kuangmk11/shieldXL-euro/kicad/shieldXL-euro/shieldXL-euro-bom.csv

Refs | Qty | Value | Footprint | Manufacturer | MPN | DigiKey PN | DigiKey PN status | Notes
C1,C4,C8,C18,C47,C63 | 6 | 100n | C0603 | Samsung | CL10B104KB8NNNC | 1276-1000-1-ND | verified
C2,C5,C10,C12,C43 | 5 | 10u | C0805 | Samsung | CL21A106KAYNNNE | 1276-2891-1-ND | verified
C3,C35,C36,C38,C39,C41,C42,C44-C46,C88 | 11 | 10n | C0603 | Samsung | CL10B103KB8NNWC | 1276-1923-1-ND | verified
C9 | 1 | 47u | C1206 | Samsung | CL31A476MPHNNNE | 1276-3063-1-ND | pattern - confirm
C11,C13 | 2 | 220p COG | C0603 | Samsung | CL10C221JB8NNNC
C14,C16 | 2 | 3.3u | C0805 | Samsung | CL21A335KAQNNNE
C15,C17 | 2 | 2700p COG | C0603 | Murata | GRM1885C1H272JA01D
C101,C102,C121 | 3 | 10u 25V / 10u | C_0805_2012Metric | Samsung | CL21A106KAYNNNE | 1276-2891-1-ND | verified
C103,C104,C117-C120,C122 | 7 | 100n | C_0805_2012Metric | Samsung | CL21B104KBCNNNC | 1276-1003-1-ND | verified
C105-C108 | 4 | 100p | C_0805_2012Metric | Samsung | CL21C101JBANNNC | 1276-1014-1-ND | pattern - confirm
C113,C114-C116 | 4 | 47u / 47u 10V | C_1206_3216Metric | Samsung | CL31A476MPHNNNE | 1276-3063-1-ND | pattern - confirm
D1,D2 | 2 | RED 3mm | LED_3mm_PadsAC | Lite-On | LTL-4211N | 160-1956-ND | verified
D101,D102 | 2 | B5819W | D_SOD-123 | EVVO | B5819W | 5272-B5819WCT-ND | verified
D103 | 1 | SMBJ5.0CA | D_SMB | Littelfuse | SMBJ5.0CA | SMBJ5.0CALFCT-ND | verified
E1-E3 | 3 | ENC | PEC11RN | Bourns | PEC11R-4215F-N0024 | PEC11R-4215F-N0024-ND | verified
F101 | 1 | 3A hold | Fuse_1812_4532Metric | Littelfuse | 1812L300MR | F4162CT-ND | verified
J101 | 1 | Eurorack power | IDC-Header_2x05_P2.54mm_Vertical | Wurth | 61201021621 |  |  | boxed 2x5; any 2.54 mm shrouded header
J102,J103,J104,J105,J115,J116,J117,J118,J119,J120 | 10 | IN L / IN R / OUT L / OUT R / CORONE I/1 / CORONE I/2 / CORONE O/1 / CORONE O/2 / CORONE O/3 / CORONE O/4 | Jack_3.5mm_QingPu_WQP-PJ398SM_Vertical_CircularHoles | Thonk | Thonkiconn PJ398SM |  |  | not at Digi-Key: Thonk / Tayda
J106,J107 | 2 | MIDI IN / MIDI OUT | Jack_3.5mm_QingPu_WQP-PJ366ST_Vertical | Thonk | Thonkiconn PJ366ST (stereo) |  |  | not at Digi-Key: Thonk
J108 | 1 | DX07S024WJ1R350 | USB_C_Receptacle_JAE_DX07S024WJ1R350 | JAE | DX07S024WJ1R350 | 670-2949-1-ND | verified | backorder at Digi-Key when checked
J109,J110,J111 | 3 | USB 1 / USB 2 / USB 3 | USB_A_Molex_105057_Vertical | Molex | 1050570001 | WM8672-ND | verified
J112,J113 | 2 | Pi USB, inner stack / Pi USB, outer stack | IDC-Header_2x04_P2.54mm_Vertical | Wurth | 61200821621 |  |  | boxed 2x4, through hole - check the Wurth variant is THT
J121 | 1 | Corone | PinHeader_2x10_P2.54mm_Vertical | Sullins | PRPC010DAAN-RC
J122 | 1 | ii | PinHeader_1x03_P2.54mm_Vertical | Sullins | PRPC003SAAN-RC | S1011EC-03-ND | pattern - confirm
J123 | 1 | MIDI OUT A/B | PinHeader_2x03_P2.54mm_Vertical | Sullins | PRPC003DAAN-RC
L3 | 1 | FERRITE | L0805 | Murata | BLM21PG221SN1D | 490-1054-1-ND | verified
Q1 | 1 | ASFL1-12.288MHZ-LCS-T | ASF | Abracon | ASFL1-12.288MHZ-L-T | 535-10810-1-ND | verified | schematic value LCS-T; Digi-Key stocks the -L-T (same 12.288 MHz 3.3 V ASFL1)
R1-R4,R11,R13,R15,R26,R28,R29,R32,R34,R35,R38,R40,R41,R44-R49 | 22 | 10k | R0603 | Yageo | RC0603FR-0710KL | 311-10.0KHRCT-ND | pattern - confirm
R5,R19,R20 | 3 | 470Ω | R0603 | Yageo | RC0603FR-07470RL | 311-470HRCT-ND | pattern - confirm
R6,R16 | 2 | 220Ω | R0603 | Yageo | RC0603FR-07220RL | 311-220HRCT-ND | pattern - confirm
R7,R9 | 2 | 1.27k | R0603 | Yageo | RC0603FR-071K27L | 311-1.27KHRCT-ND | pattern - confirm
R8,R10 | 2 | 4.53k | R0603 | Yageo | RC0603FR-074K53L | 311-4.53KHRCT-ND | pattern - confirm
R12,R14 | 2 | 590 | R0603 | Yageo | RC0603FR-07590RL | 311-590HRCT-ND | pattern - confirm
R17 | 1 | 100Ω | R0603 | Yageo | RC0603FR-07100RL | 311-100HRCT-ND | pattern - confirm
R18 | 1 | 47Ω | R0603 | Yageo | RC0603FR-0747RL | 311-47.0HRCT-ND | pattern - confirm
R101,R103 | 2 | 69.8k | R_0805_2012Metric | Yageo | RC0805FR-0769K8L | 311-69.8KCRCT-ND | pattern - confirm
R102,R104 | 2 | 30.1k | R_0805_2012Metric | Yageo | RC0805FR-0730K1L | 311-30.1KCRCT-ND | pattern - confirm
R105,R108 | 2 | 10k | R_0805_2012Metric | Yageo | RC0805FR-0710KL | 311-10.0KCRCT-ND | pattern - confirm
R106,R109 | 2 | 16.2k | R_0805_2012Metric | Yageo | RC0805FR-0716K2L | 311-16.2KCRCT-ND | pattern - confirm
R107,R110 | 2 | 1k | R_0805_2012Metric | Yageo | RC0805FR-071KL | 311-1.00KCRCT-ND | pattern - confirm
R111,R112 | 2 | 5.1k | R_0805_2012Metric | Yageo | RC0805FR-075K1L | 311-5.10KCRCT-ND | pattern - confirm
SW1-SW3 | 3 | D6R00 F1 LFS | SW_CK_D6R | C&K | D6R00 F1 LFS | 108-D6R00F1LFS-ND | verified | white cap
U$1 | 1 | FPC1M20P-B310 | F-FPC1M20P-B310 | Ckmtw | F-FPC1M20P-B310 |  |  | not at Digi-Key: LCSC C132515
U1 | 1 | PCM3060PW | TSSOP-28_4.4x9.7mm_P0.65mm | TI | PCM3060PW | 296-21668-5-ND | verified | replaces the EOL CS4270; needs software/pcm3060-moirae
U2 | 1 | HCPL-0631-500E | SSOP-8_3.9x5.05mm_P1.27mm | Broadcom | HCPL-0631-500E | 516-1580-1-ND | verified
U11 | 1 | TPS793475DBVR | SSOP5 | TI | TPS793475DBVR | 296-TPS793475DBVRCT-ND | verified
U101 | 1 | TL074 | SOIC-14_3.9x8.7mm_P1.27mm | TI | TL074CDR | 296-1283-1-ND | verified
U102-U104 | 3 | USBLC6-2SC6 | SOT-23-6 | ST | USBLC6-2SC6 | 497-5235-1-ND | verified
U105 | 1 | 74LVC1G125 | SOT-23-5 | TI | SN74LVC1G125DBVR | 296-11603-1-ND | verified
X1 | 1 | RASPI_BOARD_B+#_E3 | RASPI_BOARD_B+_UPPER_HOLES | Raspberry Pi | Raspberry Pi 4 Model B |  |  | plus a 2x20 stacking header for the 20 mm stack
(J123) | 2 | shunt | - | Sullins | SPC02SYAN | S9001-ND | verified | MIDI out A/B: both on the top row = Type A
(X1) | 1 | 2x20 stacking header | - |  | 2x20 2.54 mm stacking header, long pins |  |  | Pi 20 mm behind the board on the 8.5 mm socket; not in the schematic
(COR1) | 2 | M3 standoff 11 mm F-F | - |  | M3 x 11 mm female-female standoff |  |  | Corone to main board, H1/H2; plus 4 M3 x 6 screws
(J112,J113) | 2 | 8-way ribbon, IDC both ends | - |  | 8-way 1.27 mm ribbon + 2x4 IDC sockets |  |  | to the two USB adapters; red stripe to pin 1 at both ends
