kuangmk11/shieldXL-euro/kicad/corone/corone-bom.csv

Refs | Qty | Value | Footprint | Manufacturer | MPN | DigiKey PN | DigiKey PN status | Notes
C1,C2,C4,C5,C7 | 5 | 10u 25V / 10u | C_0805_2012Metric | Samsung | CL21A106KAYNNNE | 1276-2891-1-ND | verified
C3,C6,C15,C30,C32-C35,C40 | 9 | 1u 25V / 1u | C_0603_1608Metric | Samsung | CL10A105KA8NNNC
C10-C13,C16,C20,C31,C36,C41,C42,C44,C60-C63,C80,C81 | 17 | 100n | C_0603_1608Metric | Samsung | CL10B104KB8NNNC | 1276-1000-1-ND | verified
C14 | 1 | 4u7 | C_0805_2012Metric | Samsung | CL21A475KAQNNNE
C17 | 1 | 2u2 | C_0603_1608Metric | Samsung | CL10A225KO8NNNC
C18,C19 | 2 | 12p | C_0603_1608Metric | Samsung | CL10C120JB8NNNC
C43 | 1 | 150n | C_0603_1608Metric | Samsung | CL10B154KA8NNNC
C50-C53 | 4 | 100p | C_0603_1608Metric | Samsung | CL10C101JB8NNNC
C70-C73 | 4 | 1n | C_0603_1608Metric | Samsung | CL10C102JB8NNNC
D1 | 1 | status | LED_0603_1608Metric | Lite-On | LTST-C191KRKT
D10,D11 | 2 | BAT54S | SOT-23 | Nexperia | BAT54S,215 | 1727-2904-1-ND | verified
FB1 | 1 | 600R@100MHz | L_0603_1608Metric | Murata | BLM18AG601SN1D | 490-1014-1-ND | verified
J1 | 1 | To main board | PinSocket_2x10_P2.54mm_Vertical | Samtec | SSW-110-01-T-D |  |  | 8.5 mm socket body (mates J121)
J2 | 1 | SWD | Tag-Connect_TC2030-IDC-NL_2x03_P1.27mm_Vertical | Tag-Connect | (pads only - TC2030-IDC-NL cable) |  |  | no part placed
J3 | 1 | Debug UART | PinHeader_1x03_P2.54mm_Vertical | Sullins | PRPC003SAAN-RC | S1011EC-03-ND | pattern - confirm
R10 | 1 | 10k | R_0603_1608Metric | Yageo | RC0603FR-0710KL | 311-10.0KHRCT-ND | pattern - confirm
R11,R52,R56,R60,R64,R72,R77 | 7 | 1k | R_0603_1608Metric | Yageo | RC0603FR-071KL | 311-1.00KHRCT-ND | pattern - confirm
R12,R13 | 2 | 2.2k | R_0603_1608Metric | Yageo | RC0603FR-072K2L | 311-2.20KHRCT-ND | pattern - confirm
R30,R70,R75 | 3 | 100k | R_0603_1608Metric | Yageo | RC0603FR-07100KL | 311-100KHRCT-ND | pattern - confirm
R40 | 1 | 30k | R_0603_1608Metric | Yageo | RC0603FR-0730KL | 311-30.0KHRCT-ND | pattern - confirm
R41 | 1 | 40k | R_0603_1608Metric | Yageo | RC0603FR-0740K2L | 311-40.2KHRCT-ND | pattern - confirm | 40k is not a 1% value: 40.2k used - confirm against crow
R50,R54,R58,R62 | 4 | 20k | R_0603_1608Metric | Yageo | RC0603FR-0720KL | 311-20.0KHRCT-ND | pattern - confirm
R51,R55,R59,R63 | 4 | 120k | R_0603_1608Metric | Yageo | RC0603FR-07120KL | 311-120KHRCT-ND | pattern - confirm
R71,R76 | 2 | 33.2k | R_0603_1608Metric | Yageo | RC0603FR-0733K2L | 311-33.2KHRCT-ND | pattern - confirm
SW1,SW2 | 2 | BOOT0 / RESET | SW_SPST_TL3342 | E-Switch | TL3342F160QG/TR | EG2531CT-ND | pattern - confirm
U1 | 1 | AMS1117-5.0 | SOT-223-3_TabPin2 | Diodes | AZ1117CH-5.0TRG1 | AZ1117CH-5.0TRG1DICT-ND | verified | AZ1117CH is the pin-compatible stocked equivalent
U2 | 1 | AP2112K-3.3 | SOT-23-5 | Diodes | AP2112K-3.3TRG1 | AP2112K-3.3TRG1DICT-ND | verified
U3 | 1 | ADS131A02IPBS | TQFP-32_7x7mm_P0.8mm | TI | ADS131A02IPBS | 296-44812-ND | verified
U4 | 1 | DAC8565IAPW | TSSOP-16_4.4x5mm_P0.65mm | TI | DAC8565IAPW | 296-22924-5-ND | verified
U5,U6 | 2 | OPA4197 | TSSOP-14_4.4x5mm_P0.65mm | TI | OPA4197IPWR | 296-45060-1-ND | verified
U7 | 1 | ADG1408YRUZ | TSSOP-16_4.4x5mm_P0.65mm | Analog Devices | ADG1408YRUZ | 505-ADG1408YRUZ-ND | verified
U8 | 1 | STM32F722RET6 | LQFP-64_10x10mm_P0.5mm | ST | STM32F722RET6 | 497-17184-ND | verified
U9 | 1 | USBLC6-2SC6 | SOT-23-6 | ST | USBLC6-2SC6 | 497-5235-1-ND | verified
Y1 | 1 | 8MHz | Crystal_SMD_3225-4Pin_3.2x2.5mm |  | 8 MHz 3225 crystal, ~10 pF load (12 pF caps)
