kuangmk11/shieldXL-euro/kicad/shieldXL-euro/3d/USB_adapter.step

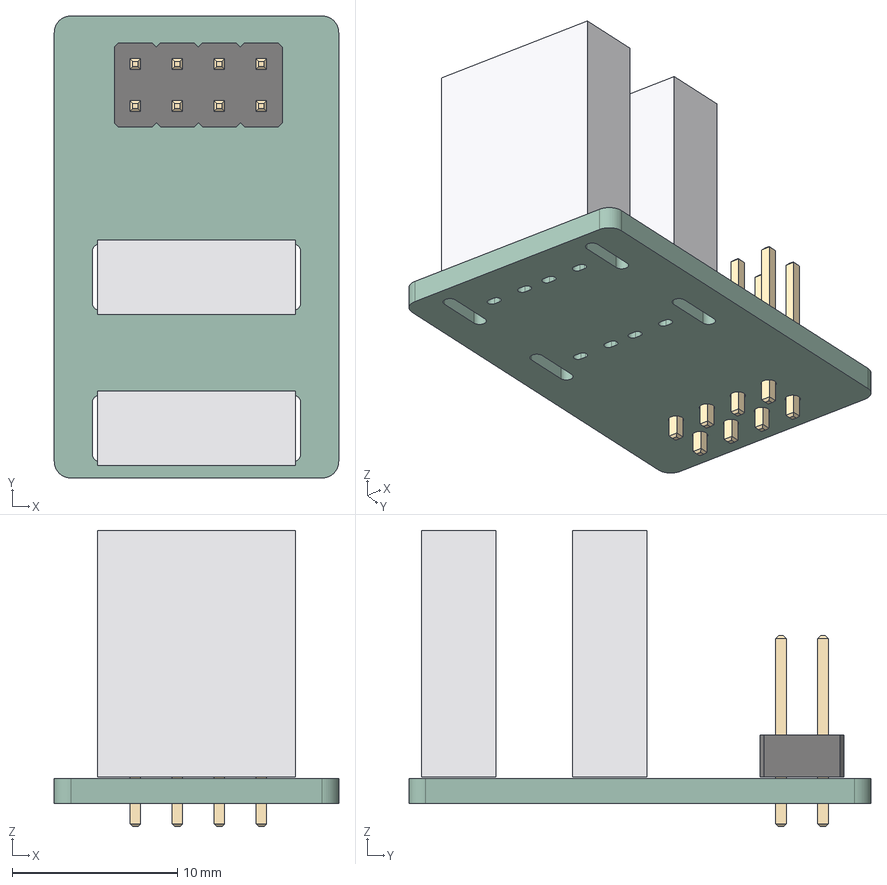
[picture p1: CAD file, 2026-10-17]
kicad/shieldXL-euro/3d/USB_adapter.step
17.2 x 27.9 x 17.9 mm
plug_PCB x 2
PinHeader_2x04_P2.54mm_Vertical
usb-adapter_PCB
