kuangmk11/shieldXL-euro/kicad/usb-adapter/3d/USB_A_plug_placeholder.step

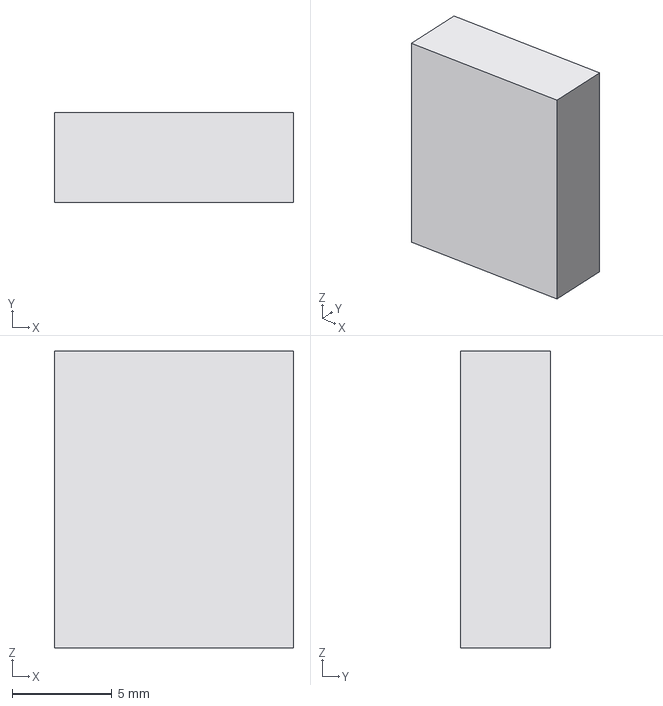
[picture p2: CAD file, 2026-10-17]
kicad/usb-adapter/3d/USB_A_plug_placeholder.step
12.0 x 4.50 x 14.9 mm
