kuangmk11/shieldXL-euro/kicad/shieldXL-euro/3d/Corone.step

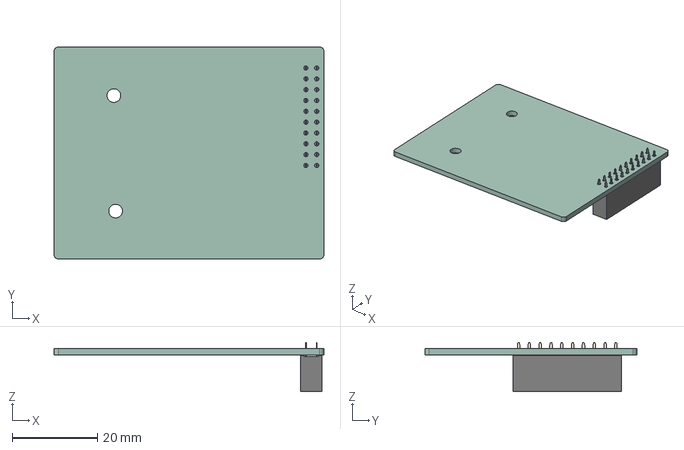
[picture p3: CAD file, 2026-10-17]
kicad/shieldXL-euro/3d/Corone.step
63.4 x 49.8 x 11.6 mm
PinSocket_2x10_P2.54mm_Vertical
corone_PCB
