kuangmk11/shieldXL-euro/kicad/shieldXL-euro/3d/Moirae_panel.step

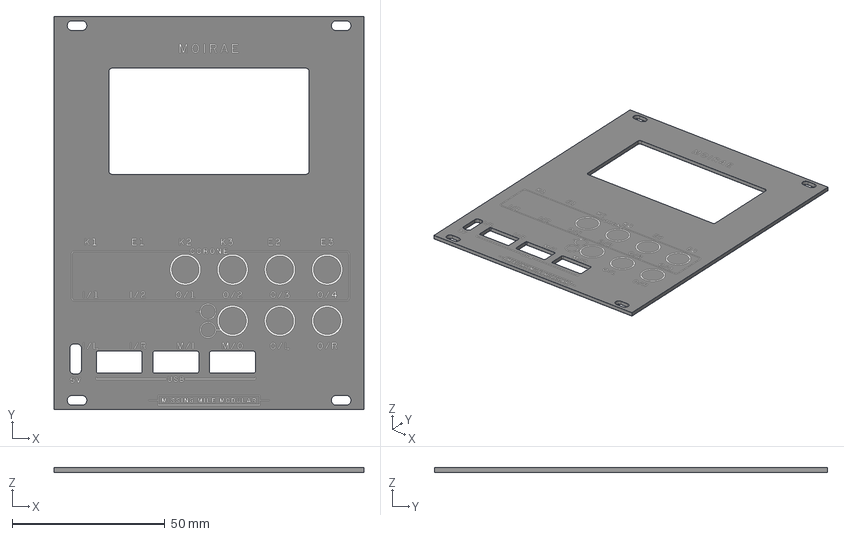
[picture p4: CAD file, 2026-10-17]
kicad/shieldXL-euro/3d/Moirae_panel.step
101.3 x 128.5 x 1.66 mm
panel_silkscreen x 2
panel_soldermask x 2
panel_PCB
