kuangmk11/shieldXL-euro/kicad/shieldXL-euro/3d/DX07S024WJ1R350.stp

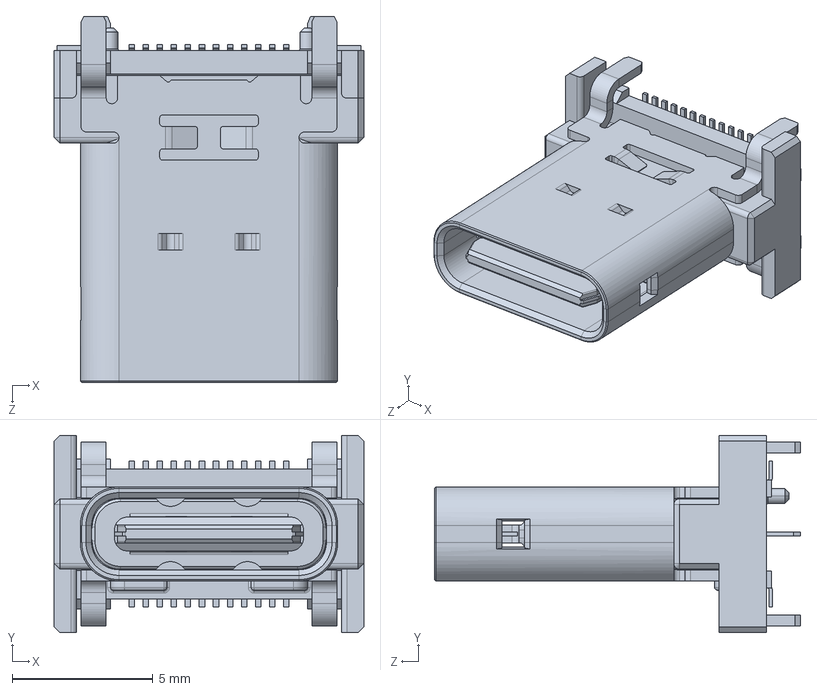
[picture p5: CAD file, 2026-10-16]
kicad/shieldXL-euro/3d/DX07S024WJ1R350.stp
11.0 x 7.00 x 13.0 mm
