kuangmk11/shieldXL-euro/kicad/shieldXL-euro/3d/NHD-2.7-12864WDx3-CTP.step

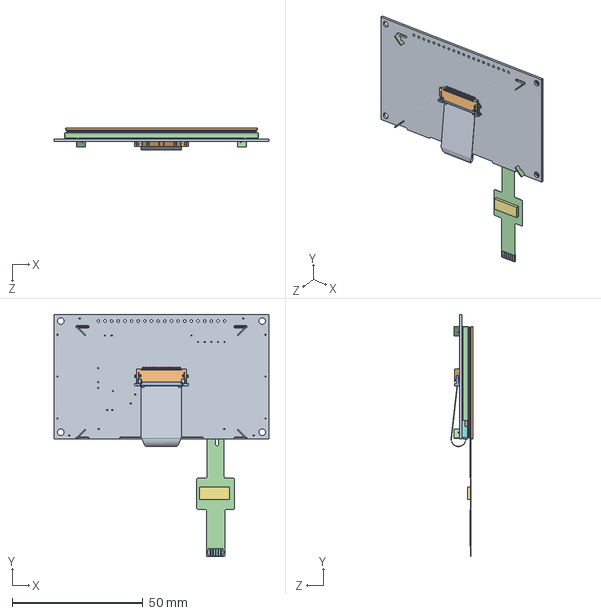
[picture p6: CAD file, 2026-10-16]
kicad/shieldXL-euro/3d/NHD-2.7-12864WDx3-CTP.step
82.0 x 92.5 x 8.34 mm
