kuangmk11/shieldXL-euro/kicad/shieldXL-euro/3d/SW-D6R00-F2-LFS.stp

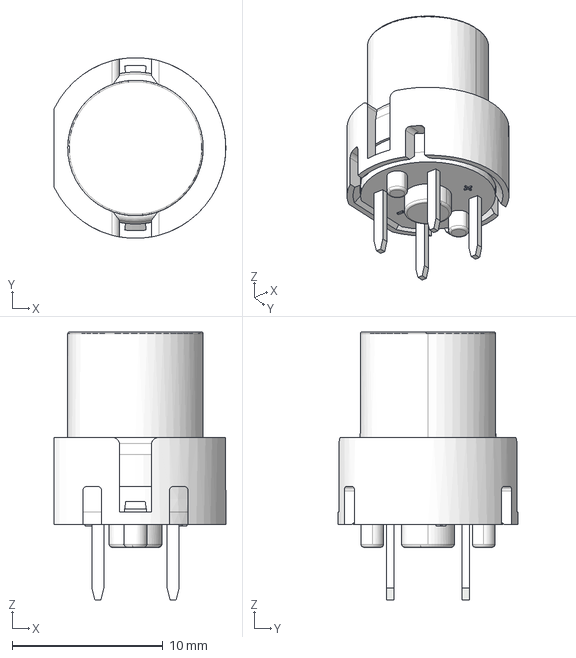
[picture p7: CAD file, 2026-10-16]
kicad/shieldXL-euro/3d/SW-D6R00-F2-LFS.stp
11.4 x 12.0 x 17.8 mm
