kuangmk11/shieldXL-euro/kicad/shieldXL-euro/3d/200MSPxT2B1M2xE.stp

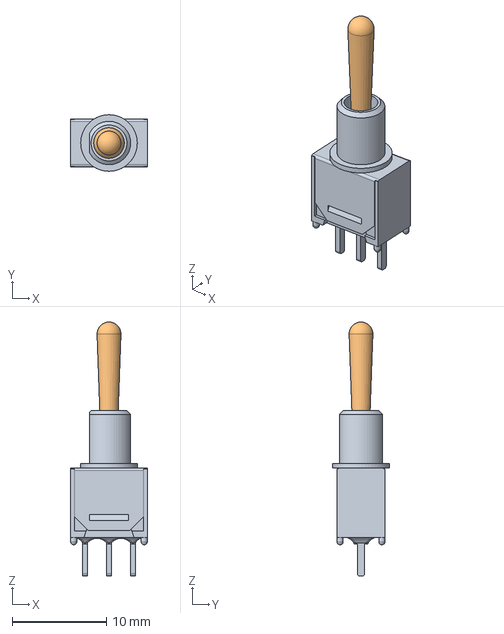
[picture p8: CAD file, 2026-10-15]
kicad/shieldXL-euro/3d/200MSPxT2B1M2xE.stp
8.13 x 6.00 x 26.9 mm
