kuangmk11/shieldXL-euro/kicad/shieldXL-euro/3d/200MDPxT2B1M2xE.stp

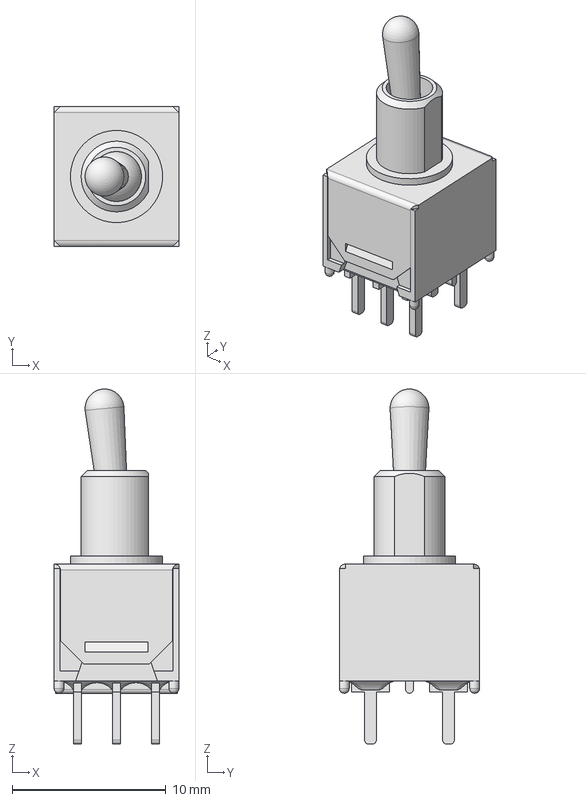
[picture p9: CAD file, 2026-10-15]
kicad/shieldXL-euro/3d/200MDPxT2B1M2xE.stp
8.13 x 9.14 x 23.1 mm
