kuangmk11/shieldXL-euro/kicad/shieldXL-euro/3d/2047110001.stp

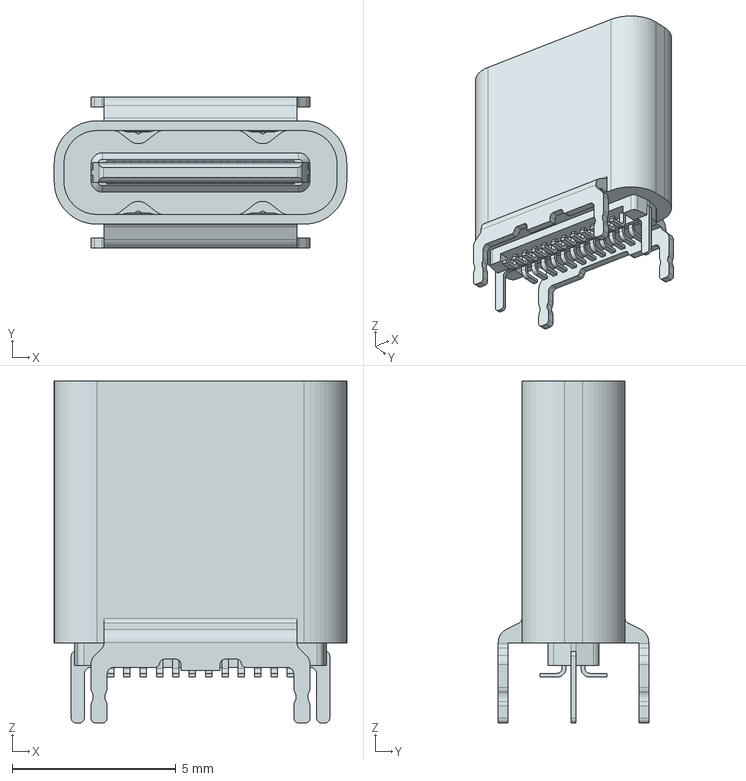
[picture p10: CAD file, 2026-10-16]
kicad/shieldXL-euro/3d/2047110001.stp
8.94 x 4.60 x 10.4 mm
