kuangmk11/shieldXL-euro/kicad/shieldXL-euro/shieldXL-euro.kicad_pcb

## KiCad design kicad/shieldXL-euro/shieldXL-euro.kicad_pcb (2026-10-17)

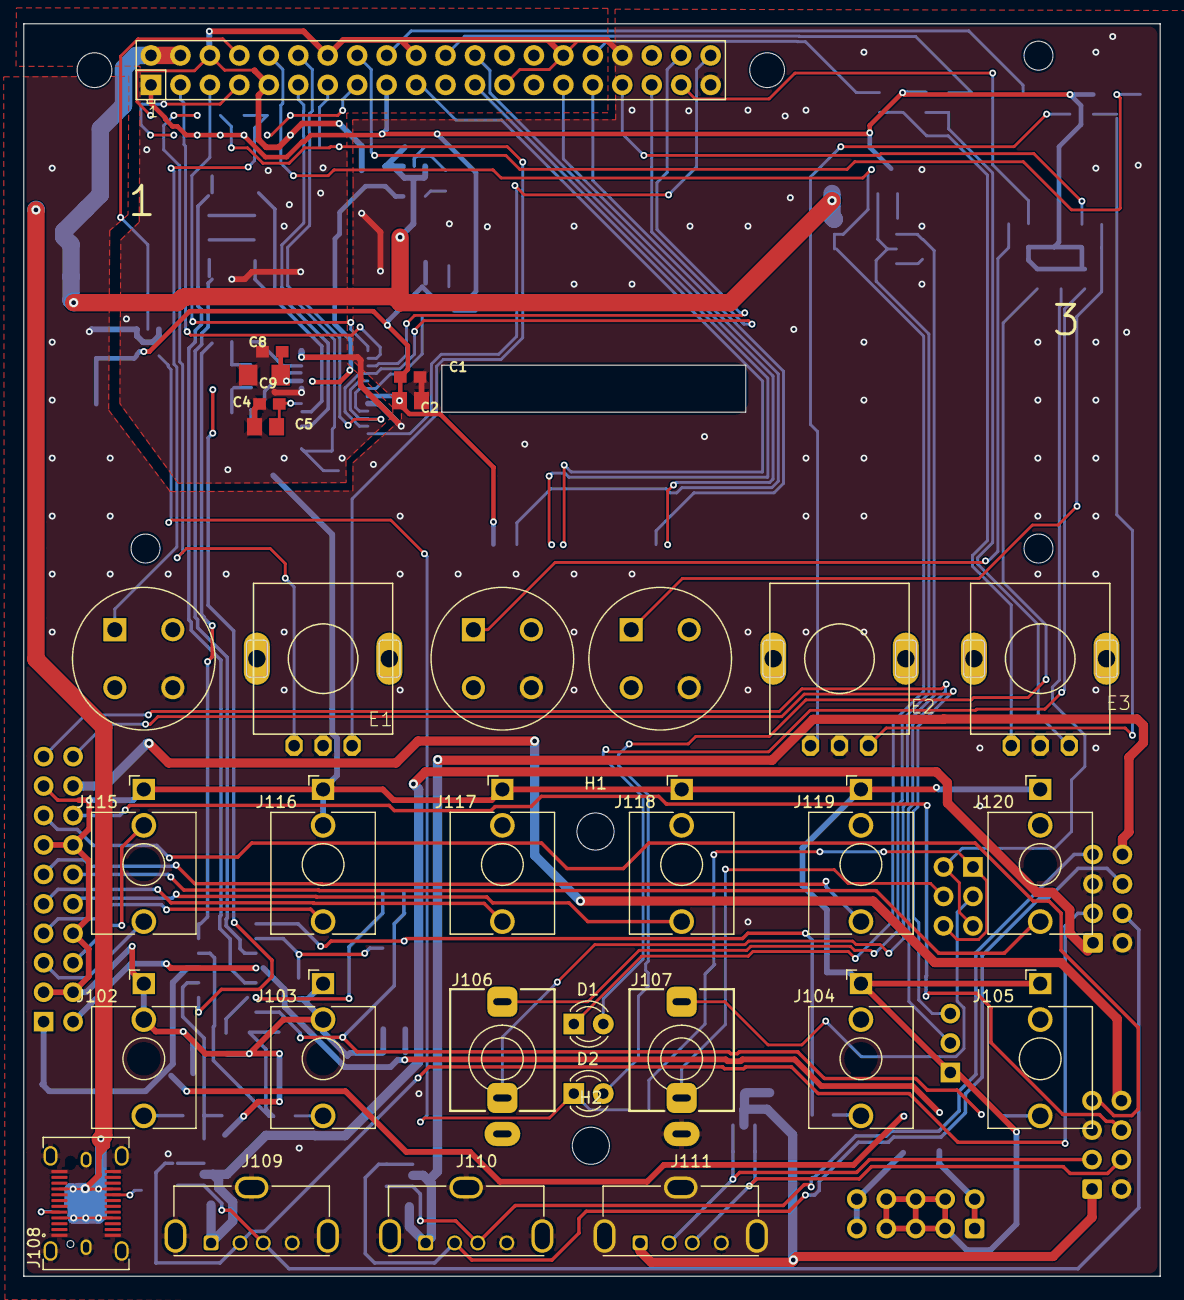
[picture p11: board shieldXL-euro.kicad_pcb from above]

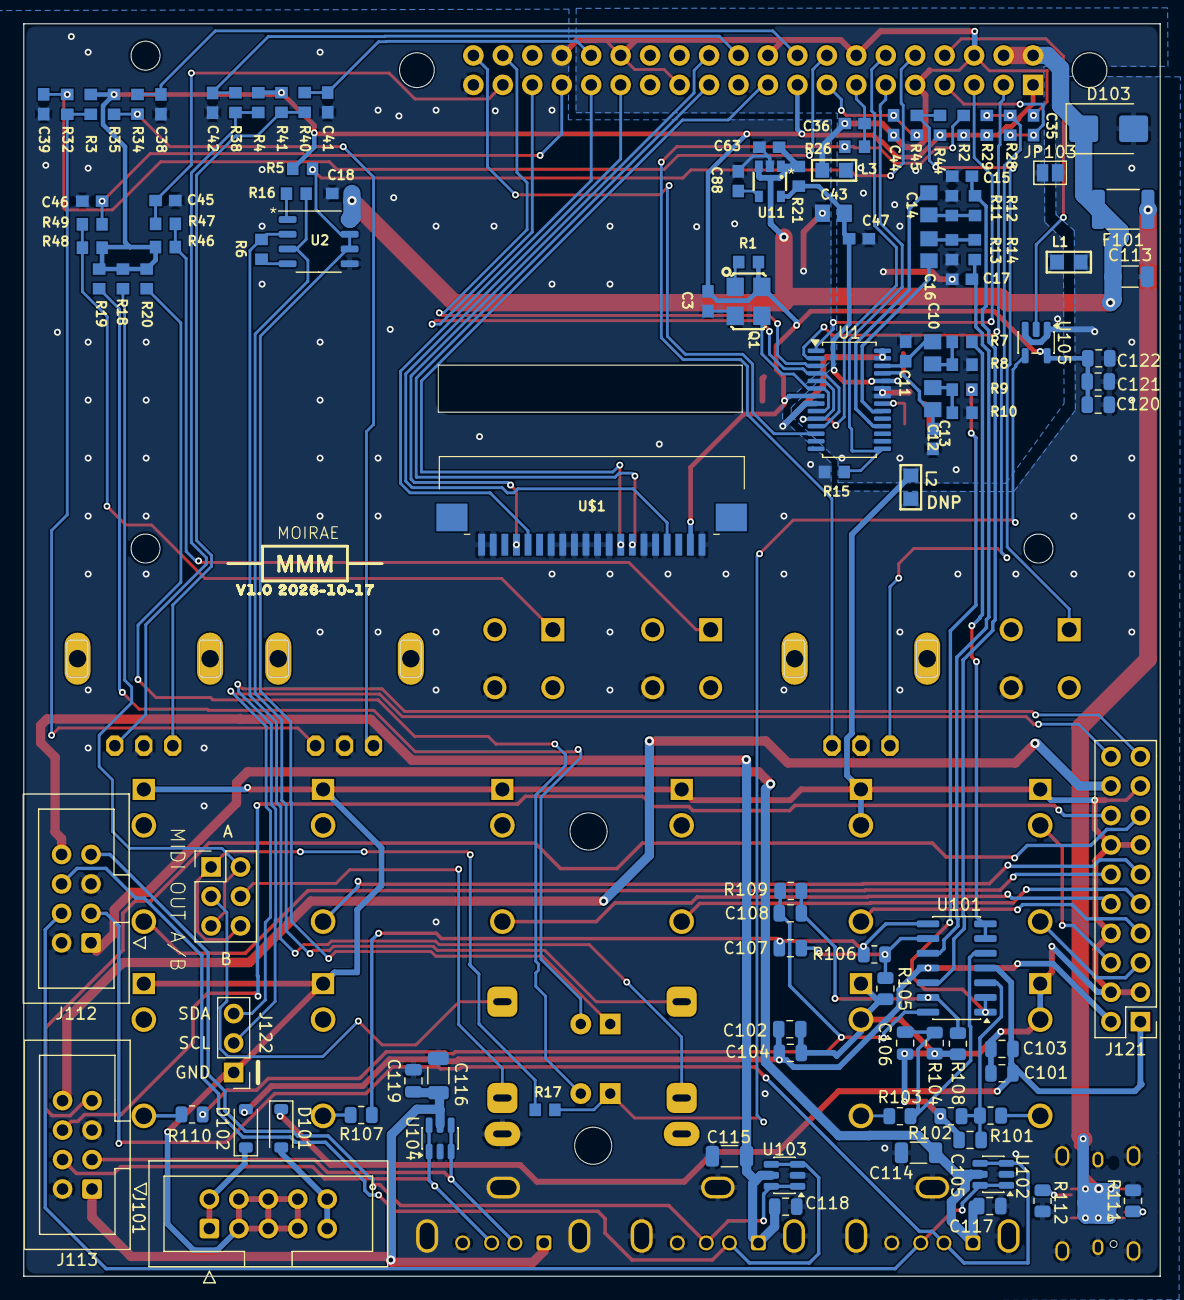
[picture p12: board shieldXL-euro.kicad_pcb from below]

Board: 2 copper layers, 98.0 x 108.0 mm, 151 parts (113 on the bottom side), 102 nets.

Parts:
C1, C4, C8, C18, C47, C63: 100n; C0603
C2, C5, C10, C12, C43: 10u; C0805
C3, C35, C36, C38, C39, C41, C42, C44, C45, C46, C88: 10n; C0603
C9: 47u; C1206
C11, C13: 220p COG; C0603
C14, C16: 3.3u; C0805
C15, C17: 2700p COG; C0603
C101, C102: 10u 25V; C_0805_2012Metric
C103, C104, C117, C118, C119, C120, C122: 100n; C_0805_2012Metric
C105, C106, C107, C108: 100p; C_0805_2012Metric
C113: 47u; C_1206_3216Metric
C114, C115, C116: 47u 10V; C_1206_3216Metric
C121: 10u; C_0805_2012Metric
COR1: Corone; Corone_Daughterboard
D1, D2: RED 3mm; LED_3mm_PadsAC
D101, D102: B5819W; D_SOD-123
D103: SMBJ5.0CA; D_SMB
DS1: NHD-2.7-12864WDW3-M; Display_NHD-2.7-12864WDW3
E1, E2, E3: ENC; PEC11RN
F101: 3A hold; Fuse_1812_4532Metric
H1, H2: M3; MountingHole_3.2mm_M3
J101: Eurorack power; IDC-Header_2x05_P2.54mm_Vertical
J102: IN L; Jack_3.5mm_QingPu_WQP-PJ398SM_Vertical_CircularHoles
J103: IN R; Jack_3.5mm_QingPu_WQP-PJ398SM_Vertical_CircularHoles
J104: OUT L; Jack_3.5mm_QingPu_WQP-PJ398SM_Vertical_CircularHoles
J105: OUT R; Jack_3.5mm_QingPu_WQP-PJ398SM_Vertical_CircularHoles
J106: MIDI IN; Jack_3.5mm_QingPu_WQP-PJ366ST_Vertical
J107: MIDI OUT; Jack_3.5mm_QingPu_WQP-PJ366ST_Vertical
J108: DX07S024WJ1R350; USB_C_Receptacle_JAE_DX07S024WJ1R350
J109: USB 1; USB_A_Molex_105057_Vertical
J110: USB 2; USB_A_Molex_105057_Vertical
J111: USB 3; USB_A_Molex_105057_Vertical
J112: Pi USB, inner stack; IDC-Header_2x04_P2.54mm_Vertical
J113: Pi USB, outer stack; IDC-Header_2x04_P2.54mm_Vertical
J115: CORONE I/1; Jack_3.5mm_QingPu_WQP-PJ398SM_Vertical_CircularHoles
J116: CORONE I/2; Jack_3.5mm_QingPu_WQP-PJ398SM_Vertical_CircularHoles
J117: CORONE O/1; Jack_3.5mm_QingPu_WQP-PJ398SM_Vertical_CircularHoles
J118: CORONE O/2; Jack_3.5mm_QingPu_WQP-PJ398SM_Vertical_CircularHoles
J119: CORONE O/3; Jack_3.5mm_QingPu_WQP-PJ398SM_Vertical_CircularHoles
J120: CORONE O/4; Jack_3.5mm_QingPu_WQP-PJ398SM_Vertical_CircularHoles
J121: Corone; PinHeader_2x10_P2.54mm_Vertical
J122: ii; PinHeader_1x03_P2.54mm_Vertical
J123: MIDI OUT A/B; PinHeader_2x03_P2.54mm_Vertical
JP103: AGND-GND; SolderJumper-2_P1.3mm_Open_Pad1.0x1.5mm
L1, L2: DNP; L0805
L3: FERRITE; L0805
PNL1: Moirae panel; Panel_Moirae
Q1: ASFL1-12.288MHZ-LCS-T; ASF
R1, R2, R3, R4, R11, R13, R15, R26, R28, R29, R32, R34, R35, R38, R40, R41, R44, R45, R46, R47, R48, R49: 10k; R0603
R5, R19, R20: 470Ω; R0603
R6, R16: 220Ω; R0603
R7, R9: 1.27k; R0603
R8, R10: 4.53k; R0603
R12, R14: 590; R0603
R17: 100Ω; R0603
R18: 47Ω; R0603
R21: DNP; R0603
R101, R103: 69.8k; R_0805_2012Metric
R102, R104: 30.1k; R_0805_2012Metric
R105, R108: 10k; R_0805_2012Metric
R106, R109: 16.2k; R_0805_2012Metric
R107, R110: 1k; R_0805_2012Metric
R111, R112: 5.1k; R_0805_2012Metric
SW1, SW2, SW3: D6R00 F1 LFS; SW_CK_D6R
U1: PCM3060PW; TSSOP-28_4.4x9.7mm_P0.65mm
U2: HCPL-0631-500E; SSOP-8_3.9x5.05mm_P1.27mm
U11: TPS793475DBVR; SSOP5
U101: TL074; SOIC-14_3.9x8.7mm_P1.27mm
U102, U103, U104: USBLC6-2SC6; SOT-23-6
U105: 74LVC1G125; SOT-23-5
U$1: FPC1M20P-B310; F-FPC1M20P-B310
USBA1, USBA2: USB adapter; USB_Adapter_Pi
X1: RASPI_BOARD_B+#_E3; RASPI_BOARD_B+_UPPER_HOLES

Connections:
+3V3: C1.1, C2.1, C3.1, C120.1, C121.1, C122.1, Q1.4 (VCC), R1.1, R2.2, R3.2, R4.2, R5.2, R18.2, R19.2, R20.2, R29.2, R35.2, R41.2, R44.1, R46.1, R48.1, U1.7 (VDD), U105.5 (VCC), U$1.2 (VDD), X1.1 (3V3A), X1.17 (3V3B)
+5V: C18.2, C63.1, C113.1, D103.1 (A1), F101.2, R21.1, U2.8 (VCC), U11.1 (IN), U11.3 (EN), X1.2 (5V0A), X1.4 (5V0B)
+12V: C101.1, C103.1, D101.1 (K), J121.1, U101.4 (V+)
-12V: C102.2, C104.2, D102.2 (A), J121.2, U101.11 (V-)
/eurorack/+12V_IN: D101.2 (A), J101.9, J101.10
/eurorack/-12V_IN: D102.1 (K), J101.1, J101.2
/eurorack/CC1: J108.A5 (CC1), R111.1
/eurorack/CC2: J108.B5 (CC2), R112.1
/eurorack/CRW_IN1: J115.T, J121.5
/eurorack/CRW_IN1_NORM: J115.TN, J121.6
/eurorack/CRW_IN2: J116.T, J121.7
/eurorack/CRW_OUT1: J117.T, J121.9
/eurorack/CRW_OUT2: J118.T, J121.10
/eurorack/CRW_OUT3: J119.T, J121.11
/eurorack/CRW_OUT4: J120.T, J121.12
/eurorack/CRW_USB_DM: J113.6, J121.16
/eurorack/CRW_USB_DP: J113.7, J121.15
/eurorack/CRW_USB_VBUS: J113.8, J121.18
/eurorack/II_SCL: J121.19, J122.2
/eurorack/II_SDA: J121.20, J122.3
/eurorack/INL_DIV: C105.1, R101.2, R102.1, U101.3 (+)
/eurorack/INR_DIV: C106.1, R103.2, R104.1, U101.5 (+)
/eurorack/IN_L_JACK: J102.T, R101.1
/eurorack/IN_R_JACK: J103.T, R103.1
/eurorack/MIDI_OUT_R: J107.R, J123.4
/eurorack/MIDI_OUT_T: J107.T, J123.3
/eurorack/OUTL_AMP: C107.2, R106.2, R107.1, U101.8
/eurorack/OUTL_FB: C107.1, R105.1, R106.1, U101.9 (-)
/eurorack/OUTR_AMP: C108.2, R109.2, R110.1, U101.14
/eurorack/OUTR_FB: C108.1, R108.1, R109.1, U101.13 (-)
/eurorack/OUT_L_JACK: J104.T, R107.2
/eurorack/OUT_R_JACK: J105.T, R110.2
/eurorack/USB1_DM: J109.2 (D-), J112.3, U102.3 (I/O2), U102.4 (I/O2)
/eurorack/USB1_DP: J109.3 (D+), J112.4, U102.1 (I/O1), U102.6 (I/O1)
/eurorack/USB1_VBUS: C114.1, C117.1, J109.1 (VBUS), J112.1, U102.5 (VBUS)
/eurorack/USB2_DM: J110.2 (D-), J112.6, U103.3 (I/O2), U103.4 (I/O2)
/eurorack/USB2_DP: J110.3 (D+), J112.7, U103.1 (I/O1), U103.6 (I/O1)
/eurorack/USB2_VBUS: C115.1, C118.1, J110.1 (VBUS), J112.8, U103.5 (VBUS)
/eurorack/USB3_DM: J111.2 (D-), J113.3, U104.3 (I/O2), U104.4 (I/O2)
/eurorack/USB3_DP: J111.3 (D+), J113.4, U104.1 (I/O1), U104.6 (I/O1)
/eurorack/USB3_VBUS: C116.1, C119.1, J111.1 (VBUS), J113.1, U104.5 (VBUS)
/eurorack/VBUS_C: F101.1, J108.A4 (VBUS), J108.A9 (VBUS), J108.B4 (VBUS), J108.B9 (VBUS)
/norns-shield-210330_1/A5V: C8.1, C9.1, C43.1, C47.1, R21.2, U1.24 (VCC), U11.6 (OUT)
/norns-shield-210330_1/INA: C10.1, C11.1, U1.26 (VINR)
/norns-shield-210330_1/INB: C12.1, C13.1, U1.25 (VINL)
/norns-shield-210330_1/LRCK: U1.4 (LRCK1), U1.11 (LRCK2), X1.35 (GPIO19)
/norns-shield-210330_1/MCLK: Q1.3 (FO), U1.6 (SCKI1), U1.9 (SCKI2)
/norns-shield-210330_1/OUTA: C14.1, U1.18 (VOUTR+)
/norns-shield-210330_1/OUTB: C16.1, U1.20 (VOUTL+)
/norns-shield-210330_1/R-CODEC: R15.1, U1.15 (~RST), X1.11 (GPIO17)
/norns-shield-210330_1/SCL: U1.1 (MC/SCL), X1.5 (SCL)
/norns-shield-210330_1/SCLK: U1.5 (BCK1), U1.10 (BCK2), X1.12 (GPIO18)
/norns-shield-210330_1/SDA: U1.2 (MD/SDA), X1.3 (SDA)
/norns-shield-210330_1/SDIN: U1.12 (DIN), X1.40 (GPIO21)
/norns-shield-210330_1/SDOUT: U1.3 (DOUT), X1.38 (GPIO20)
A1: C35.1, R28.2, X1.7 (GPIO04)
A2: C38.1, R34.2, X1.18 (GPIO24)
A3: C41.1, R40.2, X1.32 (GPIO12)
AGND: C4.2, C5.2, C8.2, C9.2, C11.2, C13.2, C15.2, C17.2, C47.2, C101.2, C102.1, C103.2, C104.1, C105.2, C106.2, J101.3, J101.4, J101.5, J101.6, J101.7, J101.8, J102.S, J102.TN, J103.S, J103.TN, J104.S, J105.S, J115.S, J116.S, J116.TN, J117.S, J118.S, J119.S, J120.S, J121.3, J121.4, J121.8, J121.13, J121.14, J121.17, J122.1, JP103.1 (A), L1.1, L2.1, L3.1, R8.2, R10.2, R11.2, R13.2, R102.2, R104.2, R105.2, R108.2, U1.16 (SGND), U1.22 (AGND2), U1.23 (AGND1)
B1: C36.1, R26.2, X1.13 (GPIO27)
B2: C39.1, R32.2, X1.16 (GPIO23)
B3: C42.1, R38.2, X1.22 (GPIO25)
CE0: U$1.17 (/CS), X1.24 (SPI_CE0)
GND: C1.2, C2.2, C3.2, C18.1, C35.2, C36.2, C38.2, C39.2, C41.2, C42.2, C43.2, C44.2, C45.2, C46.2, C63.2, C88.2, C113.2, C114.2, C115.2, C116.2, C117.2, C118.2, C119.2, C120.2, C121.2, C122.2, D103.2 (A2), E1.GND, E2.GND, E3.GND, J107.S, J108.A1 (GND), J108.A12 (GND), J108.B1 (GND), J108.B12 (GND), J108.SH (SHIELD), J109.4 (GND), J109.SH (Shield), J110.4 (GND), J110.SH (Shield), J111.4 (GND), J111.SH (Shield), J112.2, J112.5, J113.2, J113.5, JP103.2 (B), L1.2, L2.2, L3.2, Q1.2 (GND), R15.2, R111.2, R112.2, SW1.SW2 (PIN-2), SW2.SW2 (PIN-2), SW3.SW2 (PIN-2), U1.8 (DGND), U1.27 (MS/ADR), U1.28 (MODE), U2.5 (GND), U11.2 (GND), U102.2 (GND), U103.2 (GND), U104.2 (GND), U105.1, U105.3 (GND), U$1.1 (VSS), U$1.5 (R/W), U$1.6 (E), U$1.9 (DB2), U$1.10 (DB3), U$1.11 (DB4), U$1.12 (DB5), U$1.13 (DB6), U$1.14 (DB7), U$1.19 (BS1), U$1.20 (BS0), X1.6 (GND_A), X1.9 (GND_B), X1.14 (GND_C), X1.20 (GND_D), X1.25 (GND_E), X1.30 (GND_F), X1.34 (GND_G), X1.39 (GND_H)
IN_L_LINE: R9.2, U101.1, U101.2 (-)
IN_R_LINE: R7.2, U101.6 (-), U101.7
K1: C44.1, R45.2, X1.15 (GPIO22)
K2: C45.1, R47.2, X1.37 (GPIO26)
K3: C46.1, R49.2, X1.33 (GPIO13)
MIDI_IN_RING: J106.R, R6.1, U2.2 (CATHODE_1)
MIDI_IN_TIP: J106.T, R16.1, U2.3 (CATHODE_2)
MIDI_OUT_SNK: J123.1, J123.6, R17.1
MIDI_OUT_SRC: J123.2, J123.5, R18.1
MIDI_RX: D1.C, R5.1, U2.6 (VO2), U2.7 (VO1), X1.10 (RXD)
MIDI_TX: U105.2, X1.8 (TXD)
MIDI_TX_BUF: D2.C, R17.2, U105.4
MOSI: U$1.8 (SDIN), X1.19 (SPI_MOSI)
unnamed: C10.2, R7.1, R8.1
unnamed: C12.2, R9.1, R10.1
unnamed: C14.2, R11.1, R12.1
unnamed: C16.2, R13.1, R14.1
unnamed: D1.A, R19.1
unnamed: D2.A, R20.1
unnamed: E1.A, R28.1, R29.1
unnamed: E1.B, R2.1, R26.1
unnamed: E2.A, R34.1, R35.1
unnamed: E2.B, R3.1, R32.1
unnamed: E3.A, R40.1, R41.1
unnamed: E3.B, R4.1, R38.1
unnamed: Q1.1 (OE), R1.2
unnamed: R44.2, R45.1, SW1.SW1 (PIN-1)
unnamed: R46.2, R47.1, SW2.SW1 (PIN-1)
unnamed: R48.2, R49.1, SW3.SW1 (PIN-1)
unnamed: C4.1, C5.1, U1.21 (VCOM)
unnamed: R16.2, U2.1 (ANODE_1)
unnamed: R6.2, U2.4 (ANODE_2)
unnamed: C88.1, U11.4 (NR)
OUT_L_LINE: C17.1, R14.2, U101.10 (+)
OUT_R_LINE: C15.1, R12.2, U101.12 (+)
O_DC: U$1.4 (D/C), X1.29 (GPIO05)
O_RESET: U$1.16 (/RES), X1.31 (GPIO06)
SCK: U$1.7 (SCLK), X1.23 (SPI_SCLK)
