kuangmk11/shieldXL-euro/kicad/corone/corone.kicad_pcb

## KiCad design kicad/corone/corone.kicad_pcb (2026-10-17)

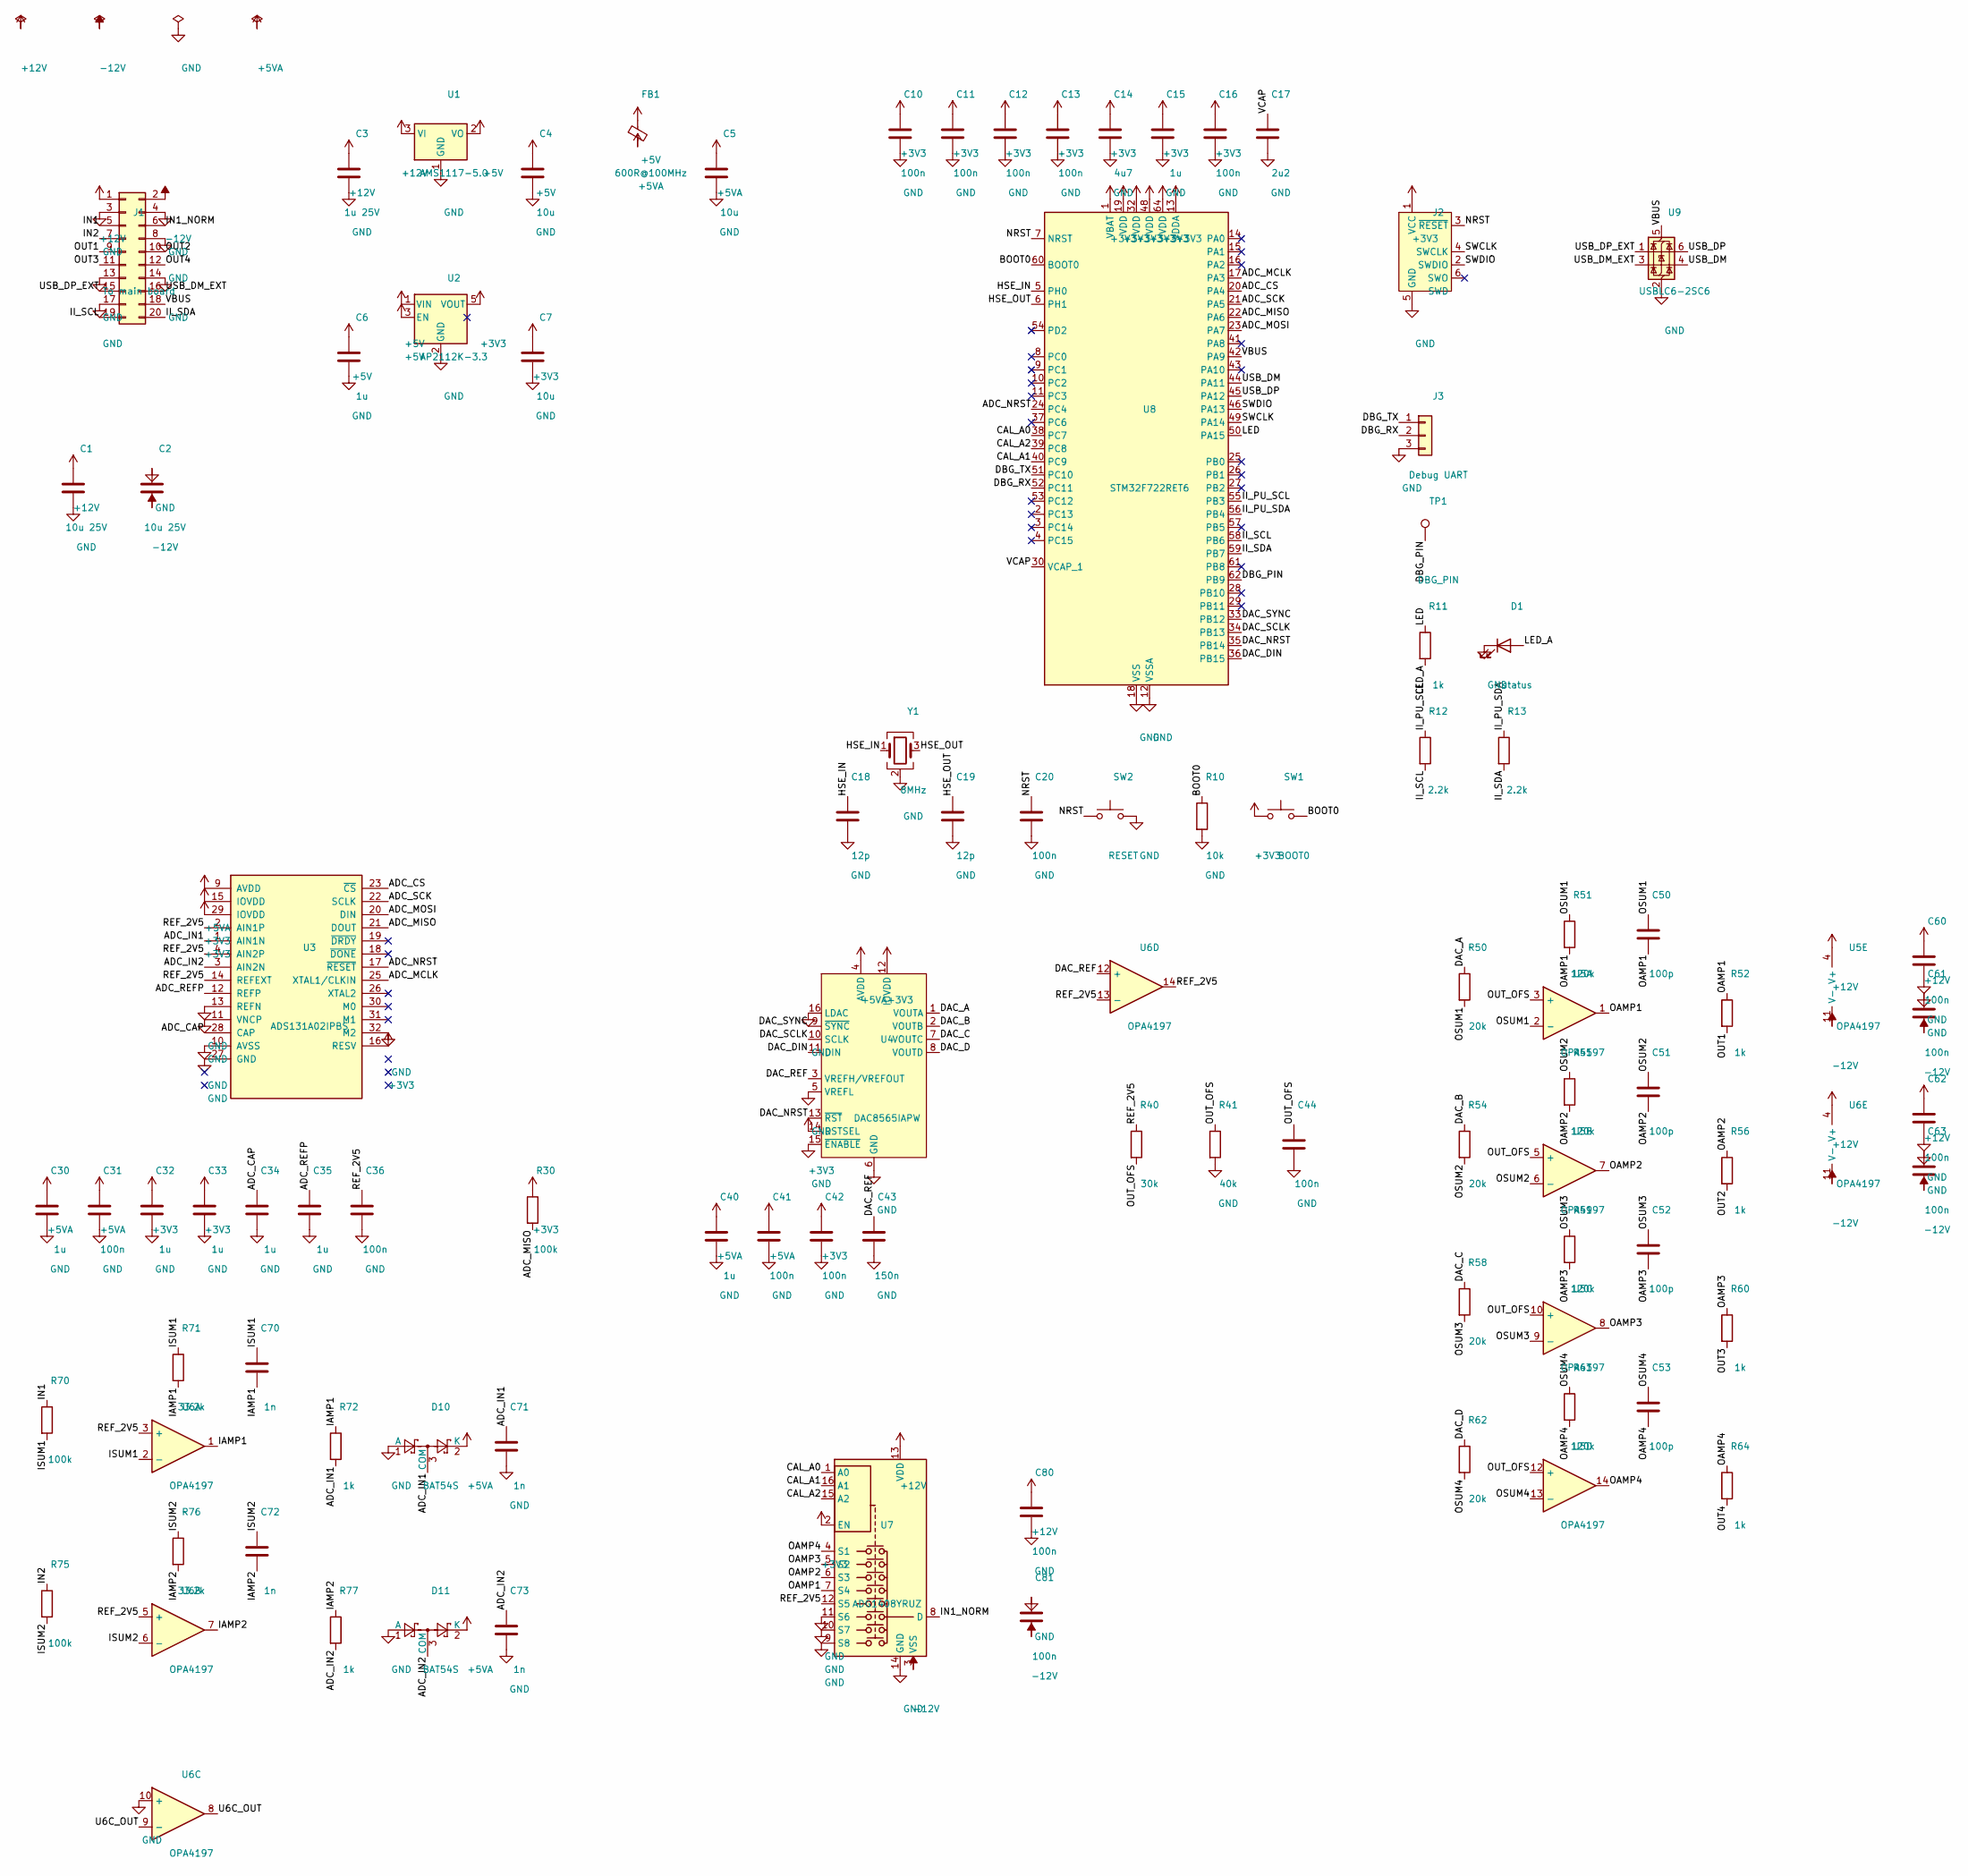
[picture p13: schematic corone.kicad_sch, Corone - crow daughterboard]

Parts:
C1, C2: 10u 25V; C_0805_2012Metric
C3: 1u 25V; C_0603_1608Metric
C4, C5, C7: 10u; C_0805_2012Metric
C6, C15, C30, C32, C33, C34, C35, C40: 1u; C_0603_1608Metric
C10, C11, C12, C13, C16, C20, C31, C36, C41, C42, C44, C60, C61, C62, C63, C80, C81: 100n; C_0603_1608Metric
C14: 4u7; C_0805_2012Metric
C17: 2u2; C_0603_1608Metric
C18, C19: 12p; C_0603_1608Metric
C43: 150n; C_0603_1608Metric
C50, C51, C52, C53: 100p; C_0603_1608Metric
C70, C71, C72, C73: 1n; C_0603_1608Metric
D1: status; LED_0603_1608Metric
D10, D11: BAT54S; SOT-23
FB1: 600R@100MHz; L_0603_1608Metric
J1: To main board; PinSocket_2x10_P2.54mm_Vertical
J2: SWD; Tag-Connect_TC2030-IDC-NL_2x03_P1.27mm_Vertical
J3: Debug UART; PinHeader_1x03_P2.54mm_Vertical
R10: 10k; R_0603_1608Metric
R11, R52, R56, R60, R64, R72, R77: 1k; R_0603_1608Metric
R12, R13: 2.2k; R_0603_1608Metric
R30, R70, R75: 100k; R_0603_1608Metric
R40: 30k; R_0603_1608Metric
R41: 40k; R_0603_1608Metric
R50, R54, R58, R62: 20k; R_0603_1608Metric
R51, R55, R59, R63: 120k; R_0603_1608Metric
R71, R76: 33.2k; R_0603_1608Metric
SW1: BOOT0; SW_SPST_TL3342
SW2: RESET; SW_SPST_TL3342
TP1: DBG_PIN; TestPoint_Pad_D1.0mm
U1: AMS1117-5.0; SOT-223-3_TabPin2
U2: AP2112K-3.3; SOT-23-5
U3: ADS131A02IPBS; TQFP-32_7x7mm_P0.8mm
U4: DAC8565IAPW; TSSOP-16_4.4x5mm_P0.65mm
U5, U6: OPA4197; TSSOP-14_4.4x5mm_P0.65mm
U7: ADG1408YRUZ; TSSOP-16_4.4x5mm_P0.65mm
U8: STM32F722RET6; LQFP-64_10x10mm_P0.5mm
U9: USBLC6-2SC6; SOT-23-6
Y1: 8MHz; Crystal_SMD_3225-4Pin_3.2x2.5mm

Connections:
+3V3: C7.1, C10.1, C11.1, C12.1, C13.1, C14.1, C15.1, C16.1, C32.1, C33.1, C42.1, J2.1 (VCC), R30.1, SW1.1, U2.5 (VOUT), U3.15 (IOVDD), U3.16 (RESV), U3.29 (IOVDD), U4.12 (IOVDD), U4.14 (RSTSEL), U7.2 (EN), U8.1 (VBAT), U8.13 (VDDA), U8.19 (VDD), U8.32 (VDD), U8.48 (VDD), U8.64 (VDD)
+5V: C4.1, C6.1, FB1.1, U1.2 (VO), U2.1 (VIN), U2.3 (EN)
+5VA: C5.1, C30.1, C31.1, C40.1, C41.1, D10.2 (K), D11.2 (K), FB1.2, U3.9 (AVDD), U4.4 (AVDD)
+12V: C1.1, C3.1, C60.1, C62.1, C80.1, J1.1, U1.3 (VI), U5.4 (V+), U6.4 (V+), U7.13 (VDD)
-12V: C2.2, C61.2, C63.2, C81.2, J1.2, U5.11 (V-), U6.11 (V-), U7.3 (VSS)
/ADC_CAP: C34.1, U3.28 (CAP)
/ADC_CS: U3.23 (~CS), U8.20 (PA4)
/ADC_IN1: C71.1, D10.3 (COM), R72.2, U3.1 (AIN1N)
/ADC_IN2: C73.1, D11.3 (COM), R77.2, U3.3 (AIN2N)
/ADC_MCLK: U3.25 (XTAL1/CLKIN), U8.17 (PA3)
/ADC_MISO: R30.2, U3.21 (DOUT), U8.22 (PA6)
/ADC_MOSI: U3.20 (DIN), U8.23 (PA7)
/ADC_NRST: U3.17 (~RESET), U8.24 (PC4)
/ADC_REFP: C35.1, U3.12 (REFP)
/ADC_SCK: U3.22 (SCLK), U8.21 (PA5)
/BOOT0: R10.1, SW1.2, U8.60 (BOOT0)
/CAL_A0: U7.1 (A0), U8.38 (PC7)
/CAL_A1: U7.16 (A1), U8.40 (PC9)
/CAL_A2: U7.15 (A2), U8.39 (PC8)
/DAC_A: R50.1, U4.1 (VOUTA)
/DAC_B: R54.1, U4.2 (VOUTB)
/DAC_C: R58.1, U4.7 (VOUTC)
/DAC_D: R62.1, U4.8 (VOUTD)
/DAC_DIN: U4.11 (DIN), U8.36 (PB15)
/DAC_NRST: U4.13 (~RST), U8.35 (PB14)
/DAC_REF: C43.1, U4.3 (VREFH/VREFOUT), U6.12 (+)
/DAC_SCLK: U4.10 (SCLK), U8.34 (PB13)
/DAC_SYNC: U4.9 (~SYNC), U8.33 (PB12)
/DBG_PIN: TP1.1 (1_1), U8.62 (PB9)
/DBG_RX: J3.2, U8.52 (PC11)
/DBG_TX: J3.1, U8.51 (PC10)
/HSE_IN: C18.1, U8.5 (PH0), Y1.1
/HSE_OUT: C19.1, U8.6 (PH1), Y1.3
/IAMP1: C70.2, R71.2, R72.1, U6.1
/IAMP2: C72.2, R76.2, R77.1, U6.7
/II_PU_SCL: R12.1, U8.55 (PB3)
/II_PU_SDA: R13.1, U8.56 (PB4)
/II_SCL: J1.19, R12.2, U8.58 (PB6)
/II_SDA: J1.20, R13.2, U8.59 (PB7)
/IN1: J1.5, R70.1
/IN1_NORM: J1.6, U7.8 (D)
/IN2: J1.7, R75.1
/ISUM1: C70.1, R70.2, R71.1, U6.2 (-)
/ISUM2: C72.1, R75.2, R76.1, U6.6 (-)
/LED: R11.1, U8.50 (PA15)
/LED_A: D1.2 (A), R11.2
/NRST: C20.1, J2.3 (~RESET), SW2.1, U8.7 (NRST)
/OAMP1: C50.2, R51.2, R52.1, U5.1, U7.7 (S4)
/OAMP2: C51.2, R55.2, R56.1, U5.7, U7.6 (S3)
/OAMP3: C52.2, R59.2, R60.1, U5.8, U7.5 (S2)
/OAMP4: C53.2, R63.2, R64.1, U5.14, U7.4 (S1)
/OSUM1: C50.1, R50.2, R51.1, U5.2 (-)
/OSUM2: C51.1, R54.2, R55.1, U5.6 (-)
/OSUM3: C52.1, R58.2, R59.1, U5.9 (-)
/OSUM4: C53.1, R62.2, R63.1, U5.13 (-)
/OUT1: J1.9, R52.2
/OUT2: J1.10, R56.2
/OUT3: J1.11, R60.2
/OUT4: J1.12, R64.2
/OUT_OFS: C44.1, R40.2, R41.1, U5.3 (+), U5.5 (+), U5.10 (+), U5.12 (+)
/REF_2V5: C36.1, R40.1, U3.2 (AIN1P), U3.4 (AIN2P), U3.14 (REFEXT), U6.3 (+), U6.5 (+), U6.13 (-), U6.14, U7.12 (S5)
/SWCLK: J2.4 (SWCLK), U8.49 (PA14)
/SWDIO: J2.2 (SWDIO), U8.46 (PA13)
/U6C_OUT: U6.8, U6.9 (-)
/USB_DM: U8.44 (PA11), U9.4 (I/O2)
/USB_DM_EXT: J1.16, U9.3 (I/O2)
/USB_DP: U8.45 (PA12), U9.6 (I/O1)
/USB_DP_EXT: J1.15, U9.1 (I/O1)
/VBUS: J1.18, U8.42 (PA9), U9.5 (VBUS)
/VCAP: C17.1, U8.30 (VCAP_1)
GND: C1.2, C2.1, C3.2, C4.2, C5.2, C6.2, C7.2, C10.2, C11.2, C12.2, C13.2, C14.2, C15.2, C16.2, C17.2, C18.2, C19.2, C20.2, C30.2, C31.2, C32.2, C33.2, C34.2, C35.2, C36.2, C40.2, C41.2, C42.2, C43.2, C44.2, C60.2, C61.1, C62.2, C63.1, C71.2, C73.2, C80.2, C81.1, D1.1 (K), D10.1 (A), D11.1 (A), J1.3, J1.4, J1.8, J1.13, J1.14, J1.17, J2.5 (GND), J3.3, R10.2, R41.2, SW2.2, U1.1 (GND), U2.2 (GND), U3.10 (AVSS), U3.11 (VNCP), U3.13 (REFN), U3.27 (GND), U3.32 (M2), U4.5 (VREFL), U4.6 (GND), U4.15 (~ENABLE), U4.16 (LDAC), U6.10 (+), U7.9 (S8), U7.10 (S7), U7.11 (S6), U7.14 (GND), U8.12 (VSSA), U8.18 (VSS), U8.31 (VSS), U8.47 (VSS), U8.63 (VSS), U9.2 (GND), Y1.2 (G), Y1.4 (G)

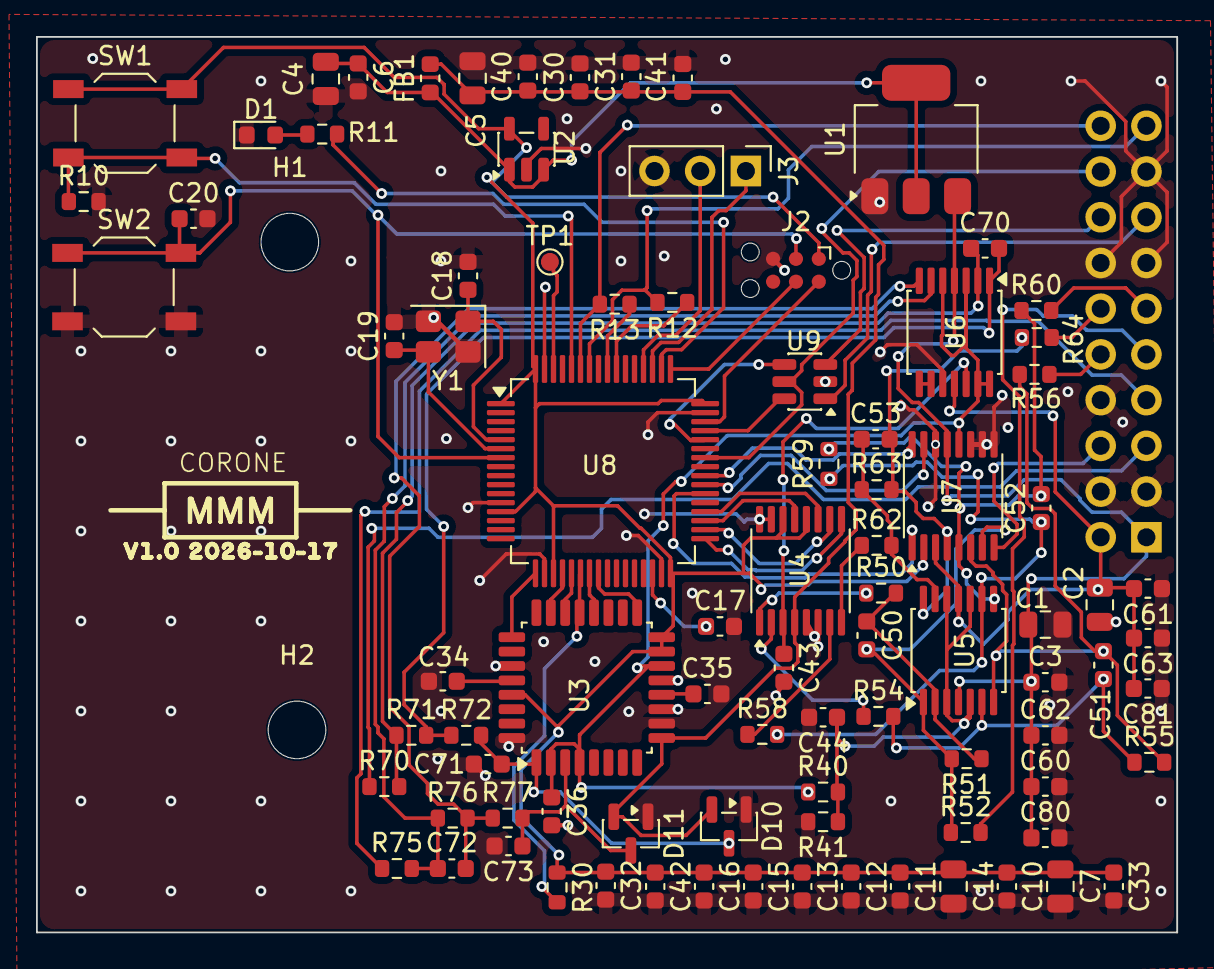
[picture p14: board corone.kicad_pcb from above]

Board: 2 copper layers, 63.3 x 49.8 mm, 91 parts (1 on the bottom side), 71 nets.

Other parts of the board:
H1, H2: M3; MountingHole_3.2mm_M3
