kuangmk11/shieldXL-euro/kicad/usb-adapter/usb-adapter.kicad_pcb

## KiCad design kicad/usb-adapter/usb-adapter.kicad_pcb (2026-10-17)

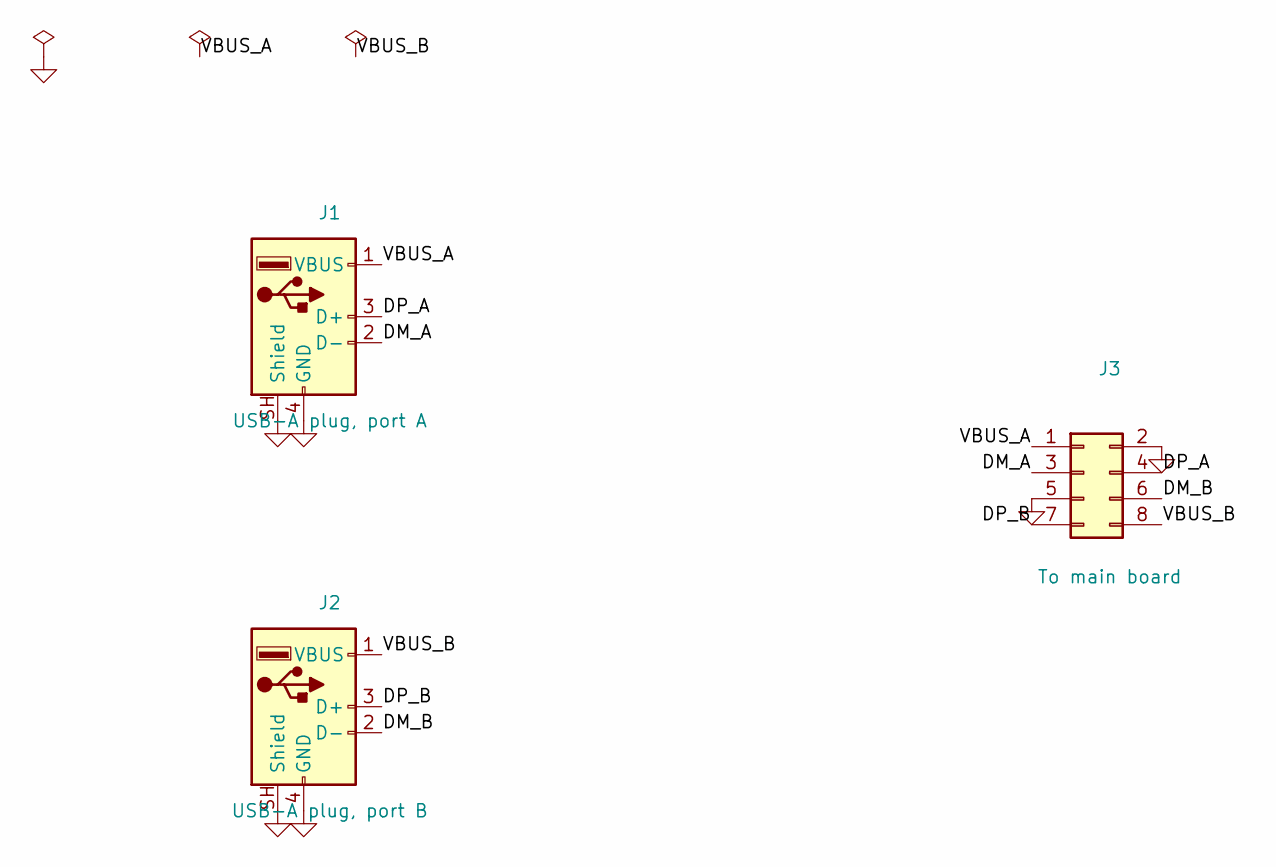
[picture p15: schematic usb-adapter.kicad_sch, Pi USB adapter]

Parts:
J1: USB-A plug, port A; USB_A_Plug_Vertical
J2: USB-A plug, port B; USB_A_Plug_Vertical
J3: To main board; PinHeader_2x04_P2.54mm_Vertical

Connections:
/DM_A: J1.2 (D-), J3.3
/DM_B: J2.2 (D-), J3.6
/DP_A: J1.3 (D+), J3.4
/DP_B: J2.3 (D+), J3.7
/VBUS_A: J1.1 (VBUS), J3.1
/VBUS_B: J2.1 (VBUS), J3.8
GND: J1.4 (GND), J1.SH (Shield), J2.4 (GND), J2.SH (Shield), J3.2, J3.5

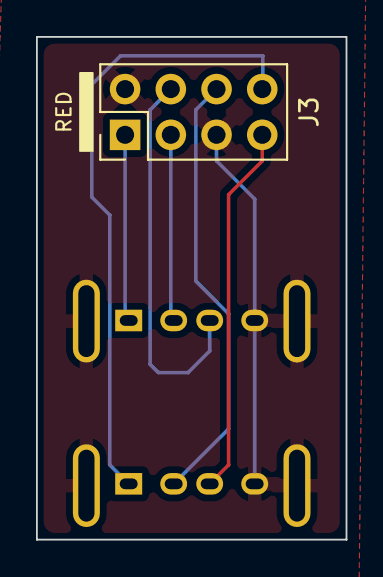
[picture p16: board usb-adapter.kicad_pcb from above]

Board: 2 copper layers, 17.2 x 27.9 mm, 3 parts (0 on the bottom side), 7 nets.
