kuangmk11/shieldXL-euro/(commit log)

2026-10-15 Start the Eurorack conversion: copy the shieldXL-M project to kicad/shieldXL-euro
    Unchanged copy of kicad/ShieldXL-M-20230615 under a new project name, as the
    baseline for the 18 HP Eurorack version. The netlist is identical to the
    original's (85 nets). The original project is left as it is so upstream fixes
    still merge.
2026-10-15 Remove the desktop I/O: 6.35 mm jacks, PJ-320B MIDI jacks, A/B slide switch
    tools/strip_shield_io.py takes J1, J2, J4, J5 off sheet 1 and J3, J6, S1 off
    sheet 2, puts a global label wherever a signal reached them (IN_L_LINE,
    IN_R_LINE, OUT_L_LINE, OUT_R_LINE, MIDI_OUT_SRC, MIDI_OUT_SNK, MIDI_IN_TIP,
    MIDI_IN_RING), and prunes the wires left hanging. Checked against the
    baseline netlist: every net keeps exactly its connections, less the removed
    parts' pins. The Eurorack I/O that replaces them comes next.
2026-10-15 Add the Eurorack I/O sheet and the MMM footprint library
    tools/make_eurorack_sheet.py writes eurorack.kicad_sch and hooks it into the
    root as page 3: 10-pin rack power (op-amps only), 3.5 mm audio in/out through
    a TL074 scaling 10 Vpp to the codec and back, PJ366ST MIDI jacks with Type A/B
    on solder jumpers, USB-C power for the Pi through a polyfuse and TVS, and three
    panel USB-A sockets cabled to the Pi. It joins the shield sheets by the global
    labels the strip step placed.
    strip_shield_io.py also removes the ground symbols left pinned to nothing once
    the jacks were gone, in the same run as the strip. MMM.pretty and its 3D models
    come from the Missing Mile Modular library; README.md covers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
2026-10-15 README: how the Pi is powered, and the USB-A cabling clearance
2026-10-16 README: the board stack, and Corone (crow on a socketed Pico)
2026-10-16 Corone: the crow daughterboard spec, read from crow's firmware
    Pin map, converters, scaling, calibration mux and header, as far as monome's
    firmware fixes them; crow's hardware itself is closed.
2026-10-16 README: Corone is a crow-firmware daughterboard, not a Pico
2026-10-16 Corone schematic, and its jacks and header on the main board
    kicad/corone: a generated schematic for the crow daughterboard, for monome's
    own firmware - STM32F722RET6, ADS131A02 (symbol from TI's pin table), DAC8565,
    OPA4197 output and input stages scaled to the firmware's conversions, ADG1408
    calibration mux onto input 1's normal, switched ii pull-ups, USB with VBUS
    sense, rack-only power. ERC: three expected warnings, no errors.
    eurorack sheet: the six CORONE jacks (I/1's switch contact carried to the
    mux), the 2 x 10 header, the ii header and a cable header for the Pi's
    fourth USB port. Main-project ERC unchanged at 35.
2026-10-16 Main board outline behind the Moirae panel, with the stack traced
    tools/make_outline.py (KiCad's Python) draws the 88 x 108 mm outline inside
    the rails, in the panel builder's frame, and traces on user layers: the panel
    (User.1), the display module (User.2), the Pi 4 upside down on the back with
    its ports toward the bottom rail (User.3) and Corone's room under it (User.4).
    shieldXL's desktop layout moves 160 mm aside as a parts stash, its outline on
    User.9.
2026-10-16 20 HP: the Pi lies landscape, header along the top
    At 18 HP the Pi had to stand portrait, and its 40-pin header then crossed the
    top row of controls. Landscape, with the header along the top behind the
    display, needs about 96 mm for the Pi, its ports, a USB adapter and the
    microSD card: 20 HP. The outline grows to 98 x 108 mm; Corone's room moves
    below the Pi.
2026-10-16 Outline: the Pi's ports where its mechanical drawing puts them
    USB stacks centred 27 and 9 mm from the edge opposite the header, Ethernet at
    45.75 - next to the header, not the USB.
2026-10-16 Pi USB adapter, and the main board's two IDC headers for it
    kicad/usb-adapter: a generated board that stands at one of the Pi 4's USB
    stacks, two vertical male USB-A plugs in its ports and a 2 x 5 IDC whose
    ribbon runs behind the Pi to the main board; two identical boards cover the
    four ports. The plug footprint and the port spacing are placeholders until
    the part is chosen and the Pi measured. Unrouted.
    eurorack sheet: J112 / J113, 2 x 5 IDC, replace the four JST cable headers;
    Corone's USB comes from J113's port B. ERC unchanged at 35.
2026-10-16 Ignore KiCad's lock files
2026-10-16 tools/place_panel_parts.py: panel parts to their holes, from the panel builder
    Keys, encoders, jacks and USB sockets to the Moirae panel's holes, the Pi
    where the outline draws it; all locked. Stops if KiCad has the board open.
2026-10-16 SSOP5: number the fifth pad 5 to match the TPS793 symbol
    The Eagle import named it pad 6, so Update PCB from Schematic reported
    'U11 pad 5 not found in ShieldXL:SSOP5' and left the LDO output unconnected.
2026-10-16 Board: U11 pad 5, and drop the uninstalled Helvetica Neue font
    U11's copy on the board still had the Eagle pad name 6. The old desktop
    silkscreen asked for Helvetica Neue, which made KiCad stop on a missing-font
    dialog every time it loaded the board; it now uses KiCad's own font.
2026-10-16 TPS793: drop the FB pin instead of renumbering the footprint
    U11 is the fixed 4.75 V TPS793475, which has no FB pin; the Eagle symbol
    carried one as pin 5 with OUT on pin 6, and the SSOP5 footprint names the
    OUT pad 6 to match. The earlier fix renumbered that pad to 5, which left OUT
    without a pad. Restore pad 6 on the footprint and the board and remove FB
    from the symbol, so F8 matches every pin.
2026-10-16 Board: update from schematic (Eurorack I/O, Corone header, USB IDC headers)
2026-10-16 Board: place and lock the panel parts and the Pi
    tools/place_panel_parts.py puts the 3 keys, 3 encoders, 12 jacks and 3 USB-A
    on their Moirae panel holes and the Pi where the outline draws it. J108
    (USB-C power) waits for a footprint. Ignore KiCad's backup folders.
2026-10-16 Board: copy the whole panel, artwork included, to the user layers
    make_outline.py now traces the panel's silkscreen as well as its cuts and
    holes: the front artwork (title, labels, output rings, CORONE box, maker
    mark) on User.1 with the outline, and the back artwork on User.5.
2026-10-16 make_outline: refuse to run while KiCad has the board open
2026-10-16 Board: follow the panel's fourth pass
    Controls down 3 mm, crow row down 2 mm, audio and MIDI down 0.5 mm, the
    CORONE outline 1 mm smaller all round; USB unchanged. Panel layers redrawn
    and the panel parts re-placed.
2026-10-16 Keys: C&K D6R00 round key switches for K1-K3
    Footprint from the ITT Cannon D6 datasheet (D-18): four 0.8 mm PC pins on a
    5.0 mm square, body d12.0, cap d9.0. The datasheet does not say which pins
    pair inside, so SW1 and SW2 take opposite corners, on different contacts
    either way; the other two pins hold the switch. Replaces shieldXL's
    Choc/MX footprint, too wide for the 13.6 mm between K2 and K3.
2026-10-16 Board: K1-K3 on the D6R footprint; keys are populated
    shieldXL left its keys unfitted (DNP) for builders to choose; Moirae fits
    the D6R00.
2026-10-16 Pi: screw down only the two holes by the header
    The other two fall on K1's and E2's pins; those corners stand on
    3D-printed feet fixed to the Pi. New footprint MMM:RASPI_BOARD_B+_UPPER_HOLES
    for X1, the feet drawn on User.3.
2026-10-16 Board: the display's FPC slot and connector, as shieldXL had them
    shieldXL's display sat with its lower-right hole on the board hole at
    (319.948, 136.417), putting the module's top-left corner at (240.448,
    91.417). The cable slot (26.21 x 4.06 mm, 1 mm corners) and U$1, the FPC
    connector on the back, keep their offsets from that corner, now measured
    from the Moirae display's corner. Slot to connector is unchanged to 0.001 mm.
2026-10-16 USB-C power: Molex 204711-0001 vertical receptacle; display holes
    J108 gets a footprint from Molex's recommended PCB layout (drawing
    2047110001 sheet 3) and the full 24-contact symbol, so all four VBUS and
    four GND contacts carry current; CC1 / CC2 keep their 5.1k, the data pins
    are left open. make_outline.py drills three of the display module's four
    holes (d2.5); the top-left one falls on the Pi header's pin 2.
2026-10-16 Board: first layout pass; USB-C on the left of the USB row
    All parts brought onto the board and placed by hand. J108 stands at 90 deg
    at the left end of the USB row (nudged 0.75 mm left to clear the panel's
    I/L label), J109-J111 moved right to make room; the panel follows. The
    placement script keeps J108 turned. Copper pours refilled.
    Known DRC: AGND track across J112 pin 9/10 and -12V_IN across J101 pins
    5/6 (shorts), R103/R104 courtyards overlap.
2026-10-16 3D models for shieldXL's parts; encoders populated
    tools/set_3d_models.py gives the Eagle-imported footprints KiCad's stock
    models, turned to match their pads (found by matching pad positions; KiCad
    turns a model the opposite way to a footprint, checked on U1's pin 1), points
    the encoders at the repo's PEC11R model instead of a missing Mac path, fixes
    U2's KiCad 6 path, and stands the 1812 resistor model in for the fuse. Q1
    takes the XO53 oscillator body (5.0 x 3.2, as the ASFL1).
    E1-E3 were do-not-populate from shieldXL, which hid them in 3D; Moirae fits
    them.
2026-10-16 Keys: C&K's D6R00 3D model
    From C&K's D6R download (white, SW-D6R00-F2-LFS.stp), its pins on the
    footprint's 5 mm square with z 0 at the board, so no offset. Added to the MMM
    house library as well.
2026-10-16 USB-A and USB-C: Molex's 3D models
    1050570001.stp on the stock 105057 footprint, raised 5.0 to its shell flange
    and moved onto pads 1-4; 2047110001.stp on J108, raised 3.82 so its legs go
    L = 1.4 below the board and the shell top lands 9.04 up, as drawn. Both
    checked in renders against their pads and from the side.
2026-10-16 Pi stack in 3D: 20 mm, socket plus stacking header
    X1 carries three models: the Pi, hung 20 mm behind the board's back so its
    USB stacks (16 mm) clear the SMD parts under them by 2 mm, and two 2x20
    socket bodies standing in for an 8.5 mm socket on the board with a stacking
    header in it. X1 is populated now (the socket is fitted to the board), so it
    shows in renders and exports.
2026-10-16 J108 to the 12 mm JAE DX07S024WJ1R350; the display in 3D
    The Molex 204711 stood 9.05 mm, about 2.5 mm short of letting a plug seat
    through the panel. The JAE high-profile receptacle stands 12.0 mm, its face
    about at the panel's front; KiCad's footprint has the same pin names, so J108
    swapped in place with its nets. Its 3D model is still to come.
    DS1 is a board-only footprint for the NHD-2.7-12864WDW3 module (outline,
    holes and viewing area on F.Fab, origin at its top-left), placed by
    place_panel_parts.py, carrying Newhaven's 3D model with the glass 9.8 mm up,
    just behind the panel. The model is the CTP variant: same module, plus a
    touch panel and its flex tail, which the -M module does not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
2026-10-16 J108: JAE's 3D model; panel opening lengthened to 9.8 mm
    JAE's model (from its SamacSys package) stands upright as supplied, lifted
    7.3 mm so the board sits on its flange and its face lands 12.0 up, about at
    the panel's front - checked from the side against the jack bodies and from
    above against its legs. Its barrel, 3.34 x 9.14 at the face, rises 2 mm into
    the panel; the opening grows from 9.4 to 9.8 mm long (0.33 a side), its
    3.8 mm width held by the I/L label.
2026-10-16 Board: panel layer redrawn - display screw holes, longer USB-C opening
    User.1 picks up the panel's four M3 holes at the display module's corners
    and the USB-C opening lengthened to 9.8 mm; with the layout saved from KiCad.
2026-10-16 Board: refill copper pours
2026-10-16 Circuit review: USB ESD and bulk, MIDI out buffer, panel MIDI LEDs, non-inverting inputs, display decoupling, AGND-GND jumper
    - U102-U104 USBLC6-2SC6 on each panel USB-A's D+/D-, with 47u + 100n on
    its VBUS (C114-C119): the ports are on the panel, the Pi 10 cm away.
    - U105 74LVC1G125 between the Pi's TXD and the MIDI out resistor and TX LED
    (MIDI_TX -> MIDI_TX_BUF): a TRS plug going in shorts tip/ring to sleeve,
    and the buffer takes that, not the Pi. R17 47 -> 100 ohm keeps that
    short under the buffer's 50 mA and the loop at about 5 mA.
    - D1 / D2 come out to the panel: red 3 mm LEDs (MMM:LED_3mm_PadsAC, pads
    named A/C for shieldXL's symbol) between the MIDI jacks, 470 ohm each.
    - I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
2026-10-16 Corone README: ii header order settled (GND, SCL, SDA; no standard)
2026-10-16 tools/set_netclasses.py: net classes and track widths for the reroute
2026-10-16 set_netclasses: name the codec nets (KiCad patterns take * and ? only)
2026-10-16 Board: MIDI LEDs on their panel holes, locked
    D1 / D2 (red 3 mm) at panel (50.35, 96.5) / (50.35, 102.5) between the MIDI
    jacks; F8 had left shieldXL's 0603 LEDs beside them under the same
    references, removed. Panel layer redrawn with the LED holes and marks.
2026-10-16 Net classes applied; all tracks and vias removed for the reroute
    tools/set_netclasses.py: Power_5V 1.5 mm, USB_VBUS 0.8, Rails_12V 0.5,
    Ground 0.5, Logic_Supply 0.4, USB_Data 0.3 (pairs 0.3/0.2), Audio 0.3,
    Default 0.25. 771 tracks and 103 vias left over from shieldXL's layout are
    gone; the pours are refilled.
2026-10-16 Corone header: swap pins 17 and 18 (GND on 17, USB VBUS sense on 18)
    Both sides of the 2x10: J121 on the main board, J1 on Corone, and the
    pinout in corone/README.md. For routing; electrically the same.
2026-10-17 Net classes: Power_5V clearance 0.25 -> 0.2
    J108's 0.5 mm-pitch VBUS pads sit 0.23 mm from their neighbours by design,
    so 0.25 flagged the connector itself; 5 V needs nothing over the default.
2026-10-17 Board: routed (first full route, before ground stitching)
2026-10-17 Ground stitching: 81 GND and 5 AGND vias; pours tidied; Power_5V 0.2
    tools/stitch_ground.py: AGND's pour now outranks GND's (7 over 6), both drop
    unconnected islands, and vias go on a 5 mm grid wherever one fits inside the
    same ground's fill on both layers (so clear of every track), then one into
    any island still on its own. Unconnected items 9 -> 2; the net classes are
    applied, so J108's pads no longer trip Power_5V's clearance.
2026-10-17 Board: routed, DRC connectivity clean (0 unconnected, parity clean)
2026-10-17 Copper-to-edge clearance 0.025 -> 0.3 mm; pours refilled
    shieldXL's 0.025 mm let the pours run to the board's edge; 0.3 mm is a
    fab's usual minimum. The 14 stitching vias on the grid's outer row (0.25 mm
    in) are removed; the rest of the stitching still joins the pours.
2026-10-17 Board: tracks pulled in from the top edge and display holes
2026-10-17 Board: routed and DRC clean
    0 unconnected, schematic parity clean, every track 0.3 mm from the edge.
    Left in DRC: the pours at 0.297 mm (fill arc tolerance), J108's pad A12 by
    its own locating peg (stock footprint), the encoders' lug cut-outs, three
    courtyard overlaps (J101/D101, J101/D102, J108/J102) and silkscreen overlaps.
2026-10-17 make_outline: drop the stash step (the stash is deleted)
    With shieldXL's parked layout gone, its marker text went too, and the old
    first-run step would have taken that as a fresh board and moved everything
    160 mm aside. make_outline now only redraws Edge.Cuts and the user layers.
2026-10-17 J122 (ii) labelled on the back: GND / SCL / SDA, a bar beside GND
    ii headers have no fixed order between modules (monome's i2c guide: connect
    by name, find GND by its mark), so each pin is named and GND is marked.
2026-10-17 The panel in 3D: PNL1, 10 mm up on the jacks' shoulders
    tools/export_panel_step.sh exports the Moirae panel (silkscreen and mask
    included) with its top-left at the origin; PNL1, a board-only footprint at
    board (100, 30), carries it 10.0 mm up - the Thonkiconns' shoulder, which the
    6.2 mm hole cannot pass. place_panel_parts.py adds and locks it as it does
    the display. Rerun the export after the panel changes.
2026-10-17 3D: black panel with white text; MIDI LEDs raised to the panel
    The panel file has no stackup, so its STEP came out in KiCad's defaults -
    translucent green, dark text. export_panel_step.sh now exports a temporary
    copy with a black core and mask (the mask exports translucent) and white
    silkscreen. D1 / D2's LED model sits 6.0 mm up, its flange on the panel's
    back, the dome through the hole: they stand on spacers.
2026-10-17 Corone: board file, outline and frame
    63.35 x 49.75 mm behind the main board's lower left, below the Pi and left of
    J101 / the USB ribbons; J1 (an 8.5 mm 2x10 socket) on the B side mating J121,
    every other part on F facing the module's rear. Corone's x is the main
    board's mirrored (x' = 266.65 - x), so J121's pin 1 is Corone (163.29, 126.3).
2026-10-17 Corone in Moirae's 3D view: J1 placed, mated to J121
    Corone's J1 (2x10 socket) goes on its board now, on B, linked to its
    schematic symbol so Update PCB keeps it; its 20 pads sit on J121's, mirrored.
    tools/export_corone_step.sh exports Corone; COR1, a board-only footprint on
    the main board, carries it turned over, its J1 side 12.6 mm behind the main
    board's front (J121's 2.5 mm base, the 8.5 mm socket). place_panel_parts.py
    keeps COR1 in place. Rerun the export as Corone's layout grows.
2026-10-17 Corone mounting: two M3 holes on both boards
    The main board's two M3 holes for Corone's standoffs, at (150.95, 109.9) and
    (150.55, 137.0), projected onto Corone as H1 / H2 (MountingHole_3.2mm_M3,
    board-only) at (115.70, 109.9) and (116.10, 137.0) in its mirrored frame.
    Corone's 3D model re-exported.
2026-10-17 Corone: GND stitching and escape vias
    stitch_ground.py takes a board path, so it stitches Corone too: 44 grid
    vias, then 12 short stubs and vias for GND pads the pour could not reach.
2026-10-17 Corone: solid zone connection on starved-thermal GND pads
2026-10-17 Corone: tie the last GND islands in; 0 unconnected
    Vias bond four floating pour pieces to the other layer's plane, and U3
    pin 32 gets a stub and via of its own.
2026-10-17 Moirae: finer arc approximation for the pour; mounting holes H1/H2 board-only
2026-10-17 MIDI out A/B: 2 x 3 header and shunts (J123) in place of the solder jumpers
    Odd pins the tip, even the ring, the middle row the jack: both shunts on
    the top row is Type A, on the bottom row Type B. J123 keeps JP101's
    symbol id, so the board links without Update PCB; its tracks are left to
    route. Also takes in the board edits saved since the last commit.
2026-10-17 Moirae: board edits after the J123 move
2026-10-17 USB adapter: port heights from the Pi 4 model (3.49 / 12.63 above its PCB)
2026-10-17 USB adapter: footprint for the USB-71 side-mount plug stood on end
    Tails straight through in plated slots at the side-mount spacing, shell
    tabs in slots at the jack's edges, insert toward the Pi's PCB. The board
    now links to the schematic (footprint ids, symbol paths, net names), so
    Update PCB leaves it alone.
2026-10-17 USB adapters: routed board, plug placeholder, and both in Moirae's 3D
    The adapter's plug tails sit on the plug's centre line (as routed); its
    3D plug is a 12 x 4.5 x 15 mm box. The generator no longer overwrites the
    hand-routed board. USBA1 / USBA2, board-only on the main board, stand the
    adapter at the Pi 4's two USB stacks (27.0 and 9.0 up its port edge), plug
    face 3 mm off the port faces.
2026-10-17 Pi USB ribbons: 8-way - boxed 2 x 4 IDC on the main board, plain 2 x 4 header on the adapters
    Pinout in ribbon order: VBUS A, GND, D- A, D+ A, GND, D- B, D+ B, VBUS B.
    Symbol ids kept, so Update PCB swaps the footprints in place.
2026-10-17 Pi USB ribbons routed on both boards; plug boxes in the adapter's 3D
    Adapter J1 / J2 carry the 15 mm plug placeholder, and its STEP is
    re-exported for Moirae. Pours refilled on both boards; the adapter's arc
    approximation tightened so its pour clears the rounded edge.
2026-10-17 USB adapter: red-stripe marker at the header's pin 1-2 end
2026-10-17 USB adapter: MMM mark, V1.0 and date on the back silk
    The monogram in its two-lead frame between the Pi reference lines, in the
    house Routed Gothic glyphs; version and date beneath, clear of the plug
    shell pads.
2026-10-17 Corone and Moirae: MMM mark, V1.0 and date on the back silk
    Corone in the open middle of its back; Moirae under the Pi, above the
    jack rows, clear of the FPC slot.
2026-10-17 BOMs for Moirae, Corone and the USB adapter, with Digi-Key numbers
    One CSV per board from each schematic, grouped, with manufacturer part
    numbers; Digi-Key numbers marked verified (found on a Digi-Key listing)
    or pattern (Yageo / Sullins / Samsung numbering, confirm before ordering).
    Moirae's lists the off-schematic hardware too. CS4270 shows obsolete at
    Digi-Key.
2026-10-17 Codec: TI PCM3060 in place of the end-of-life CS4270
    U1 swaps in place on the shield sheet (tools/swap_codec_pcm3060.py, pin
    map there): same wires, same uuid, so Update PCB brings in the TSSOP-28.
    I2C at 0x46 (MODE and ADR low); ADC and DAC share the clocks; the codec
    stays clock master off the 12.288 MHz crystal, the DAC driving BCK/LRCK
    and the ADC following. FILT+ caps C6/C7 off the board.
    Levels re-set for the PCM3060 at 4.75 V: input divider 1.27k / 4.53k into
    its 10k input (13.3 Vpp full scale), output gain 2.62 (R106/R109 16.2k)
    for 10 Vpp from its 3.8 Vpp single-ended DAC.
    Software: the kernel's pcm3060 driver with one DT flag so the ADC stays a
    clock consumer (software/pcm3060-mo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
2026-10-17 PCM3060: decoupling within ~3 mm of its pins; DRC clean
