kuangmk11/shieldXL-euro/(notices)

Notices in the files:
parts and their libraries:
Imported from clacktronics/AudioJacks (github.com/clacktronics/AudioJacks, rev 14a8886, MIT, (c) 2021 Barwise - see doc/AudioJacks-LICENSE.txt).
